will-conrad/plasma-donut/tools/README.md

# tools/

Helper scripts for working with the board, e.g. flashing a UF2 with `picotool`,
or opening the USB serial log (`screen /dev/tty.usbmodem* 115200`) and saving the
CSV output.
