will-conrad/plasma-donut/src/drivers/README.md

# drivers/

Chip-level drivers, one `.c`/`.h` pair per part (SDK `hardware_spi`, `hardware_adc`, `hardware_clocks`, `hardware_pio`):
- MCP3208 external ADC (SPI) — `../../docs/parts/mcp3208.md`
- ST7565R LCD controller / NHD-C12864LZ display (SPI) — `st7565r.md`, `nhd_c12864lz.md`
- RP2350 internal ADC (GPIO26–28) — `rp2350.md`, `pico2.md`
- Oscillator frequency counter on GPIO22 — `rp2350.md`
