will-conrad/plasma-donut/src/ui/README.md

# ui/

What the user sees and presses: LCD pages, button handling (debounce) —
`../../docs/parts/omron_b3f.md` — and backlight PWM (duty capped, see
`../../docs/ISSUES.md`).
