will-conrad/plasma-donut/docs/parts/specs.csv

part | category | parameter | symbol | min | typ | max | unit | conditions | pdf_page | section | tags
pico2 | power | VBUS input (USB) | VBUS |  | 5 |  | V | ±10% | 13 | Recommended operating conditions | usb,5v,supply
pico2 | power | VSYS input range | VSYS | 1.8 |  | 5.5 | V | feeds RT6150 buck-boost | 13 | Recommended operating conditions | vsys,supply,input
pico2 | power | 3V3 pin external load (recommended) |  |  |  | 300 | mA | depends on RP2350 load and VSYS | 10 | Pin descriptions (3V3) | 3v3,vcc,budget,current
pico2 | power | 3V3_EN pull-up |  |  | 100 |  | kΩ | to VSYS; short low to disable 3.3 V | 10 | Pin descriptions (3V3_EN) | enable
pico2 | power | VBUS→VSYS diode | D1 |  | Schottky |  |  | VSYS = VBUS − diode drop; safe to OR another source via diode/PFET | 16 | 5.4 Powerchain | oring,schottky,vsys
pico2 | analog | ADC_VREF filter | R7/C |  | 201 Ω / 2.2 µF |  |  | from 3V3; ~150 µA ADC draw gives ~30 mV offset | 15 | 5.3 Using the ADC | adc_vref,vref,offset
pico2 | analog | ADC_VREF external shunt option |  |  | 3.0 |  | V | LM4040 suggested; ~1.5 mA through 200 Ω | 15 | 5.3 Using the ADC | vref,lm4040
pico2 | io | ADC-capable GPIO26–29 max input |  |  |  | IOVDD+0.3 | V | internal diode to IOVDD; leaks into 3V3 if unpowered | 15 | 5.2 GPIO | gpio26,gpio27,gpio28,overvoltage
pico2 | io | Internal-use GPIOs |  |  |  |  |  | GPIO23 SMPS PS, GPIO24 VBUS sense, GPIO25 LED, GPIO29 VSYS/3 | 9 | Mechanical spec, pin notes | gpio23,gpio24,gpio25,gpio29,reserved
pico2 | pinout | Power pins |  |  |  |  |  | 40 VBUS, 39 VSYS, 37 3V3_EN, 36 3V3, 35 ADC_VREF, 33 AGND | 9 | Pin numbering | pinout,vbus,vsys
pico2 | thermal | Operating temperature |  | -20 |  | 85 | °C | incl. self-heating; recommended max ambient 70 °C | 13 | Recommended operating conditions | temperature
pico2 | power | SMPS mode pin | GPIO23 |  |  |  |  | drive high = PWM mode, lower ripple on ADC_VREF | 15 | 5.3 Using the ADC | ripple,noise,gpio23
rp2350 | absmax | IOVDD | IOVDD | -0.5 |  | 3.63 | V |  | 1336 | 14.9.1 Absolute maximum ratings | absmax,supply
rp2350 | absmax | Voltage at IO (standard pin) | VPIN | -0.5 |  | IOVDD+0.5 | V |  | 1336 | 14.9.1 | absmax,gpio,overvoltage
rp2350 | absmax | Voltage at IO (FT pin) | VPIN_FT | -0.5 |  | 5.5 | V | IOVDD = 3.3 V present; 3.63 V if IOVDD = 0 | 1336 | 14.9.1 | absmax,5v tolerant,ft
rp2350 | io | Input high (standard) | VIH | 2.0 |  | IOVDD+0.3 | V | IOVDD = 3.3 V | 1337 | 14.9.4 Table 1683 | vih,logic level
rp2350 | io | Input low | VIL | -0.3 |  | 0.8 | V | IOVDD = 3.3 V | 1337 | 14.9.4 | vil,logic level
rp2350 | io | Input hysteresis | VHYS | 0.2 |  |  | V | IOVDD = 3.3 V, Schmitt enabled | 1337 | 14.9.4 | schmitt,hysteresis
rp2350 | io | Output high | VOH | 2.62 |  | IOVDD | V | IOVDD = 3.3 V at IOH = 2/4/8/12 mA setting | 1337 | 14.9.4 | voh,drive
rp2350 | io | Output low | VOL | 0 |  | 0.5 | V | IOVDD = 3.3 V at IOL setting | 1337 | 14.9.4 | vol,drive
rp2350 | io | Pin input leakage | IIN |  |  | 1 | µA | (see erratum E9 for mid-rail inputs) | 1337 | 14.9.4 | leakage
rp2350 | io | Pull-up resistance | RPU | 32 |  | 86 | kΩ | IOVDD = 3.3 V | 1338 | 14.9.4 | pull-up,buttons
rp2350 | io | Pull-down resistance | RPD | 36 |  | 113 | kΩ | IOVDD = 3.3 V (unreliable: E9) | 1338 | 14.9.4 | pull-down,buttons,e9
rp2350 | io | Total GPIO source current | IIOVDD_MAX |  |  | 100 | mA | sum of all GPIO | 1338 | 14.9.4 | current,budget
rp2350 | io | Total GPIO sink current | IIOVSS_MAX |  |  | 100 | mA | sum of all GPIO | 1338 | 14.9.4 | current,budget
rp2350 | errata | E9: leakage when input pad is mid-rail | RP2350-E9 |  | 120 |  | µA | pad sources current, sits ~2.2 V; overcome with ≤8.2 kΩ drive; pull-ups OK, pull-downs fail | 1359 | Appendix D.5.1 | e9,errata,pull-down,leakage,buttons
rp2350 | pwm | PWM B pin as counter input | DIVMODE |  |  |  |  | only B pins (odd GPIO) count edges; high and low periods must each exceed one clk_sys period | 980 | 12.5 PWM (input modes) | frequency counter,pwm,odd gpio,edge count
rp2350 | pwm | Two GPIOs on the same PWM B input are OR'd |  |  |  |  |  | e.g. GPIO1 and GPIO17 are both PWM0 B — use a different slice for each frequency input | 976 | 12.5 GPIO→PWM mapping | pwm slice,conflict,frequency counter
rp2350 | clocks | Frequency counter FC0 interval vs accuracy | FC0_INTERVAL |  |  |  |  | 1 µs→2048 kHz … 500 µs→4 kHz; measures internal/GPIN clocks | 476 | 8.1.4 Frequency counter | frequency counter,gpin
rp2350 | thermal | Junction temperature | TJ | -40 |  | 125 | °C |  | 1336 | 14.9.1 | temperature
mcp3208 | absmax | VDD | VDD |  |  | 7.0 | V |  | 2 | 1.0 Absolute maximum | absmax,supply
mcp3208 | absmax | Any input/output |  | -0.6 |  | VDD+0.6 | V | w.r.t. VSS | 2 | 1.0 Absolute maximum | absmax,overvoltage,input
mcp3208 | power | Operating supply | VDD | 2.7 |  | 5.5 | V |  | 3 | Power requirements | supply
mcp3208 | power | Operating current | IDD |  | 320 | 400 | µA | VDD = VREF = 5 V; 225 µA typ at 2.7 V | 3 | Power requirements | current,budget
mcp3208 | accuracy | Resolution |  |  | 12 |  | bit |  | 2 | DC accuracy | resolution
mcp3208 | accuracy | INL | INL |  | ±0.75 | ±1 | LSB | -B grade; -C grade ±2 max | 2 | DC accuracy | inl,linearity,grade
mcp3208 | accuracy | DNL | DNL |  | ±0.5 | ±1 | LSB | no missing codes | 2 | DC accuracy | dnl
mcp3208 | accuracy | Offset error |  |  | ±1.25 | ±3 | LSB |  | 2 | DC accuracy | offset,calibration
mcp3208 | accuracy | Gain error |  |  | ±1.25 | ±5 | LSB |  | 2 | DC accuracy | gain,calibration
mcp3208 | reference | VREF range | VREF | 0.25 |  | VDD | V |  | 2 | Reference input | vref,vref_adc
mcp3208 | reference | VREF current |  |  | 100 | 150 | µA | while converting; 3 µA max in standby | 2 | Reference input | vref,load
mcp3208 | analog | Analog input range CH0–7 |  | VSS |  | VREF | V | single-ended | 2 | Analog inputs | input range
mcp3208 | analog | Sample capacitor | CSAMPLE |  | 20 |  | pF |  | 3 | Analog inputs / Fig 4-1 | source impedance,sample cap,kickback
mcp3208 | analog | Sampling switch resistance | RSS |  | 1000 |  | Ω |  | 3 | Analog inputs / Fig 4-1 | source impedance
mcp3208 | timing | Sample time | tSAMPLE |  | 1.5 |  | clocks |  | 2 | Conversion rate | source impedance,acquisition
mcp3208 | timing | Conversion time | tCONV |  |  | 12 | clocks |  | 2 | Conversion rate
mcp3208 | timing | Throughput | fSAMPLE |  |  | 100 / 50 | ksps | VDD = 5 V / 2.7 V | 2 | Conversion rate | sample rate
mcp3208 | timing | SPI clock | fCLK |  |  | 2.0 / 1.0 | MHz | VDD = 5 V / 2.7 V | 3 | Timing parameters | spi,clock,speed
mcp3208 | timing | Minimum effective clock |  | 10 |  |  | kHz | below this the sample cap droops (Note 3, §6.2) | 3 | Timing note 3 | spi,clock,minimum
mcp3208 | timing | CS disable time | tCSH | 500 |  |  | ns |  | 3 | Timing parameters | spi,cs
mcp3208 | digital | VIH / VIL |  | 0.7·VDD |  | 0.3·VDD | V |  | 3 | Digital I/O | logic level
mcp3208 | interface | SPI modes |  |  | 0,0 and 1,1 |  |  | 3-byte transfer, §6.1 | 1 | Features / §6.1 | spi,mode
mcp3208 | pinout | SOIC-16 pinout |  |  |  |  |  | 1–8 CH0–CH7, 9 DGND, 10 CS/SHDN, 11 DIN, 12 DOUT, 13 CLK, 14 AGND, 15 VREF, 16 VDD | 15 | Table 3-1 | pinout
mcp3208 | layout | Bypass capacitor |  |  | 1 |  | µF | as close as possible to VDD pin | 23 | 6.4 Layout considerations | decoupling,bypass,layout
mcp3208 | layout | Ground pins |  |  |  |  |  | connect BOTH AGND and DGND to the analog ground plane (internally 5–10 Ω apart) | 24 | 6.5 Digital and analog ground pins | gnda,ground,layout
mcp3208 | layout | Trace routing |  |  |  |  |  | keep digital/clock traces away from analog; no traces under device or bypass cap; star VDD | 23 | 6.4 Layout considerations | layout,routing
mcp3208 | thermal | Operating temperature | TA | -40 |  | 125 | °C |  | 4 | Temperature characteristics | temperature
nhd_c12864lz | power | Supply voltage | VDD | 2.7 | 3.0 | 3.3 | V |  | 7 | Electrical characteristics | supply,vcc,3v3
nhd_c12864lz | power | Supply current | IDD | 0.2 | 0.5 | 2.0 | mA | VDD = 3.0 V | 7 | Electrical characteristics | current,budget
nhd_c12864lz | power | LCD drive (contrast) voltage | VLCD | 8.2 | 8.5 | 8.8 | V | 25 °C, generated internally | 7 | Electrical characteristics | contrast,vlcd
nhd_c12864lz | digital | Input high | VIH | 0.8·VDD |  | VDD | V | = 2.64 V at 3.3 V | 7 | Electrical characteristics | logic level,vih
nhd_c12864lz | digital | Input low | VIL | VSS |  | 0.2·VDD | V |  | 7 | Electrical characteristics | logic level,vil
nhd_c12864lz | backlight | LED backlight current | ILED | 60 | 80 | 100 | mA | drive by current, not voltage | 7 | Electrical characteristics | backlight,led,current
nhd_c12864lz | backlight | LED backlight voltage | VLED | 2.7 | 3.0 | 3.3 | V | ILED = 80 mA | 7 | Electrical characteristics | backlight,led,forward voltage
nhd_c12864lz | thermal | Operating temperature | TOP | -20 |  | 70 | °C |  | 7 | Electrical characteristics | temperature,heat
nhd_c12864lz | pinout | 28-pin LCD connector |  |  |  |  |  | 1 /CS1, 2 /RES, 3 A0, 4 /WR, 5 /RD, 6–11 DB0–DB5 (NC in serial), 12 DB6=SCL, 13 DB7=SI, 14 VDD, 15 VSS, 16 VOUT, 17–21 charge-pump caps, 22–26 V4–V0, 27 C86, 28 PS (L = serial) | 6 | Pin description | pinout,spi,serial
nhd_c12864lz | passives | Charge-pump and bias caps |  |  | 1 |  | µF | VOUT, CAP pins 1 µF; V0–V4 1.0–2.2 µF to VSS | 6 | Pin description | capacitors,bom
nhd_c12864lz | mechanical | Connector pitch |  |  | 1.27 |  | mm | LCD pins; backlight pins 1.5 mm wide; breakout NHD-PCB40 | 6 | Pin description | footprint,pitch
nhd_c12864lz | firmware | Example init sequence |  |  |  |  |  | A2, A0, C8, C0, 40, 25, 81, 19, 2F, AF (note C8 is immediately overridden by C0) | 13 | Example initialization program | init,firmware,contrast
nhd_c12864lz | optical | Response time (rise) | Tr |  | 150 |  | ms |  | 7 | Optical characteristics
st7565r | absmax | Supply VDD / VDD2 | VDD | -0.3 |  | 3.6 | V |  | 56 | Absolute maximum ratings | absmax,supply
st7565r | absmax | V0, VOUT |  | -0.3 |  | 13.5 | V |  | 56 | Absolute maximum ratings | absmax
st7565r | timing | 4-line SPI clock period | tSCYC | 50 |  |  | ns | VDD = 3.3 V (100 ns at 2.7 V) | 64 | Table 28/29 | spi,clock,speed
st7565r | timing | SCL high / low width | tSHW/tSLW | 25 |  |  | ns | VDD = 3.3 V (50 ns at 2.7 V) | 64 | Table 28/29 | spi
st7565r | timing | A0 setup / hold | tSAS/tSAH | 20 / 10 |  |  | ns | VDD = 3.3 V (30/20 ns at 2.7 V) | 64 | Table 28/29 | spi,a0
st7565r | timing | SI setup / hold | tSDS/tSDH | 20 / 10 |  |  | ns | VDD = 3.3 V | 64 | Table 28/29 | spi
st7565r | timing | CS–SCL time | tCSS/tCSH | 20 / 40 |  |  | ns | VDD = 3.3 V (30/60 ns at 2.7 V) | 64 | Table 28/29 | spi,cs
st7565r | timing | Reset low pulse width | tRW | 1.0 |  |  | µs | VDD = 3.3 V (2.0 µs at 2.7 V) | 65 | Table 30/31 | reset
st7565r | timing | Reset time | tR |  |  | 1.0 | µs | VDD = 3.3 V (2.0 µs at 2.7 V) | 65 | Table 30/31 | reset
st7565r | interface | SPI data format |  |  |  |  |  | SI sampled on SCL rising edge, MSB (D7) first; A0 read every 8th clock; write-only (no reads in SPI mode) | 24 | 4-line SPI interface | spi,mode,msb
st7565r | interface | SCL noise caution |  |  |  |  |  | SCL sensitive to line-end reflections and external noise — recheck on real hardware | 24 | 4-line SPI interface | noise,rf,emi
ntcs0603e3 | electrical | R25 | R25 |  | 10000 |  | Ω | 103 = 10 kΩ | 1 | Electrical data and ordering | resistance
ntcs0603e3 | electrical | R25 tolerance (F suffix) |  |  | ±1 |  | % | J ±5, H ±3, G ±2, F ±1 | 1 | Ordering note 1 | tolerance
ntcs0603e3 | electrical | B25/85 (…103*LT) | B25/85 |  | 3435 |  | K | ±1 %; 'L' = 3435 K, 'M' = 3610 K, 'H' = 3960 K | 1 | Electrical data and ordering | beta,b value,firmware
ntcs0603e3 | electrical | Max power at 25 °C | Pmax25 |  |  | 125 | mW |  | 1 | Quick reference data | power,self-heating
ntcs0603e3 | electrical | Dissipation factor | D |  | 3.0 |  | mW/K |  | 1 | Quick reference data | self-heating
ntcs0603e3 | thermal | Thermal time constant | τ |  |  | <4 | s |  | 1 | Quick reference data | response time
ntcs0603e3 | thermal | Operating temperature |  | -55 |  | 150 | °C | zero power | 1 | Quick reference data | temperature
ao3400a | absmax | Drain-source voltage | VDS |  |  | 30 | V |  | 1 | Absolute maximum | absmax
ao3400a | absmax | Gate-source voltage | VGS | -12 |  | 12 | V |  | 1 | Absolute maximum | absmax,gate
ao3400a | absmax | Continuous drain current | ID |  |  | 5.7 | A | TA = 25 °C (4.7 A at 70 °C) | 1 | Absolute maximum | current
ao3400a | electrical | Gate threshold | VGS(th) | 0.65 | 1.05 | 1.45 | V | ID = 250 µA | 2 | Static parameters | threshold,logic level
ao3400a | electrical | RDS(on) at VGS = 2.5 V | RDS(on) |  | 24 | 48 | mΩ | ID = 3 A | 2 | Static parameters | rdson,3.3v gate
ao3400a | electrical | RDS(on) at VGS = 4.5 V | RDS(on) |  | 19 | 32 | mΩ | ID = 5 A | 2 | Static parameters | rdson
ao3400a | electrical | Input capacitance | Ciss |  | 630 |  | pF | VDS = 15 V, 1 MHz | 2 | Dynamic parameters | gate charge,pwm
ao3400a | electrical | Total gate charge | Qg |  | 6 | 7 | nC | VGS = 4.5 V | 2 | Switching parameters | gate charge,pwm
ao3400a | thermal | RθJA steady state | RθJA |  | 100 | 125 | °C/W | 1 in² 2 oz Cu | 1 | Thermal characteristics | thermal
ao3400a | pinout | SOT-23 pinout |  |  |  |  |  | 1 G, 2 S, 3 D | 1 | Package drawing | pinout
nx_74lvc1g17 | pinout | SOT753 (GV) pinout |  |  |  |  |  | 1 n.c., 2 A, 3 GND, 4 Y, 5 VCC — matches U4/U5 pads | 3 | 6.2 Table 3 | pinout
nx_74lvc1g17 | absmax | VCC / VI |  | -0.5 |  | 6.5 | V | VI negative rating may be exceeded if IIK ≤ 50 mA | 4 | 8 Table 5 | absmax,negative input,clamp
nx_74lvc1g17 | absmax | Input clamp current | IIK | -50 |  |  | mA | VI < 0 V | 4 | 8 Table 5 | clamp
nx_74lvc1g17 | power | VI (operating) | VI | 0 |  | 5.5 | V |  | 5 | 9 Table 6 | input range
nx_74lvc1g17 | threshold | Positive-going threshold | VT+ | 1.29 | 1.5 | 1.71 | V | VCC = 3.0 V, −40…85 °C (no 3.3 V row) | 6 | 10.1 Table 8 | schmitt,threshold,bias
nx_74lvc1g17 | threshold | Negative-going threshold | VT− | 0.88 | 1.0 | 1.24 | V | VCC = 3.0 V | 6 | 10.1 Table 8 | schmitt,threshold,bias
nx_74lvc1g17 | threshold | Hysteresis | VH | 0.31 | 0.5 | 0.64 | V | VCC = 3.0 V | 6 | 10.1 Table 8 | hysteresis
nx_74lvc1g17 | timing | Propagation delay A→Y | tpd | 0.7 | 3.0 | 5.5 | ns | VCC 3.0–3.6 V, CL = 50 pF, RL = 500 Ω | 8 | 11 Table 9 | tpd,skew,phase
nx_74lvc1g17 | power | Power dissipation capacitance | CPD |  | 16.6 |  | pF | VCC = 3.3 V | 8 | Table 9 note 3 | dynamic current
nx_74lvc1g17 | power | Supply current | ICC |  | 0.1 | 4 | µA | VI = rail, IO = 0 | 5 | 10 Table 7 | current
nx_74lvc1g17 | power | Extra current, input at VCC−0.6 V | ΔICC |  | 5 | 500 | µA | per input | 6 | 10 Table 7 | bias,current
nx_74lvc1g86 | pinout | SOT753 (GV) pinout |  |  |  |  |  | 1 B, 2 A, 3 GND, 4 Y, 5 VCC — matches U3 pads | 3 | 6.2 Table 3 | pinout
nx_74lvc1g86 | absmax | VCC / VI |  | -0.5 |  | 6.5 | V |  | 4 | 8 Table 5 | absmax
nx_74lvc1g86 | digital | VIH / VIL |  | 2.0 |  | 0.8 | V | VCC 2.7–3.6 V (min VIH / max VIL) | 5 | 10 Table 7 | logic level
nx_74lvc1g86 | digital | VOH at −100 µA | VOH | VCC−0.1 |  |  | V | light load (R20 10k into C26) | 5 | 10 Table 7 | phase,output level
nx_74lvc1g86 | digital | VOL at 100 µA | VOL |  |  | 0.10 | V |  | 5 | 10 Table 7 | phase,output level
nx_74lvc1g86 | timing | Propagation delay A/B→Y | tpd | 0.5 | 2.3 | 5.0 | ns | VCC 3.0–3.6 V, CL = 50 pF | 6 | 11 Table 8 | tpd,phase
nx_74lvc1g86 | power | Power dissipation capacitance | CPD |  | 25 |  | pF | VCC = 3.3 V | 6 | Table 8 | dynamic current
yageo_rc_l | power | RC0805 rated power | P70 |  |  | 0.125 | W | at 70 °C, derate to 0 at 155 °C | 5 | Electrical characteristics / Power rating | power,derating,0805
yageo_rc_l | power | RC1206 rated power | P70 |  |  | 0.25 | W | at 70 °C (R1 24 Ω) | 6 | Electrical characteristics | power,1206,backlight
yageo_rc_l | electrical | RC0805 max working voltage |  |  |  | 150 | V | overload 300 V | 5 | Electrical characteristics | voltage,0805
yageo_rc_l | electrical | RC1206 max working voltage |  |  |  | 200 | V | overload 400 V | 6 | Electrical characteristics | voltage,1206
yageo_rc_l | electrical | TCR (1 %, 10 Ω–10 MΩ) |  |  |  | ±100 | ppm/°C |  | 5 | Electrical characteristics | tcr
omron_b3f | electrical | Switch rating (resistive) |  | 1 |  | 50 | mA | 3–24 VDC (B3F-G variant for 100 µA) | 3 | Ratings/Characteristics | switch,minimum current,buttons
omron_b3f | electrical | Bounce time |  |  |  | 5 | ms |  | 3 | Ratings/Characteristics | debounce,buttons
omron_b3f | electrical | Contact resistance |  |  |  | 100 | mΩ | initial | 3 | Ratings/Characteristics | contact
omron_b3f | thermal | Operating temperature |  | -25 |  | 70 | °C |  | 3 | Ratings/Characteristics | temperature
rp2350 | adc | ADC input range | VPIN_ADC | 0 |  | ADC_AVDD | V |  | 1339 | 14.9 Table 1685 | adc,vdd tap,passive
rp2350 | adc | ADC ENOB | ENOB | 9 | 9.5 |  | bits |  | 1339 | Table 1685 | adc,resolution
rp2350 | adc | ADC input impedance | RIN_ADC | 100 |  |  | kΩ | loads high-Z dividers (DC-07) | 1339 | Table 1685 | adc,impedance,divider
rp2350 | clocks | GPIN0/GPIN1 clock inputs |  |  |  | 50 | MHz | GPIN0 = GPIO20, GPIN1 = GPIO22 (FREQ_QUARTZ!) → measurable with FC0 | 19 | Pin function table / 8.1 | gpin,gpio22,frequency counter
rp2350 | clocks | FC0 longest interval | FC0_INTERVAL |  |  | 32 ms → 62.5 Hz |  | accuracy vs interval | 476 | Table 574 | frequency counter,resolution
