will-conrad/plasma-donut/docs/rework_map.png

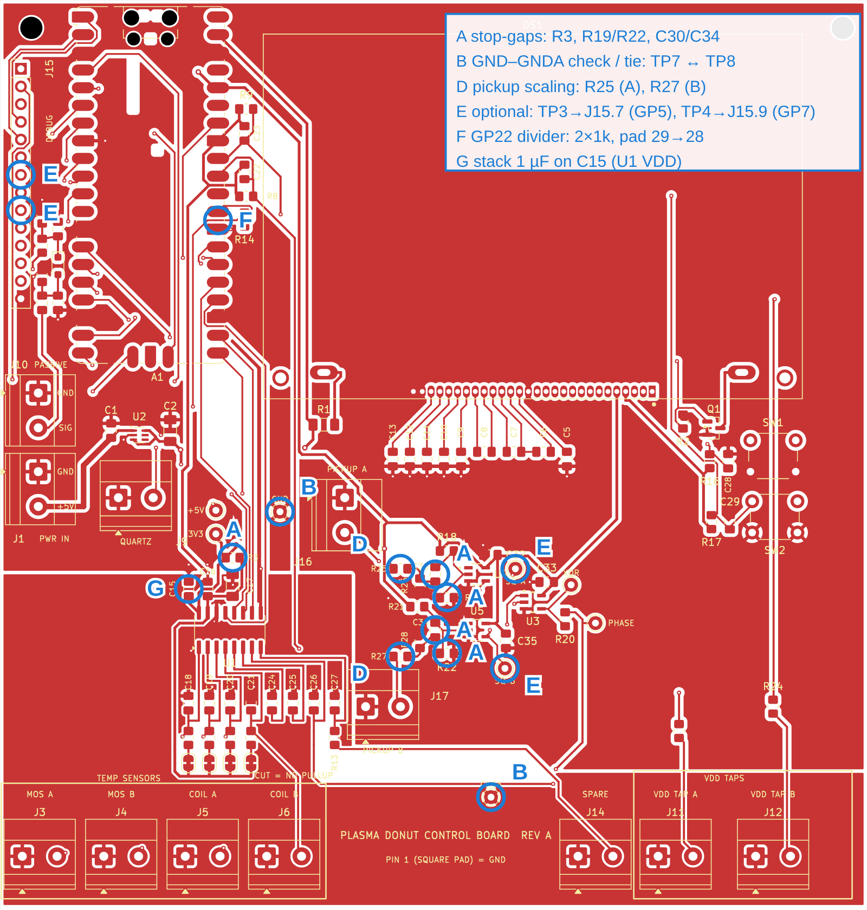
docs/rework_map.png
