will-conrad/plasma-donut/docs/parts/ao3400a.md

# AO3400A

| | |
|---|---|
| Manufacturer | Alpha & Omega |
| Role on board | Low-side N-FET for LCD backlight (PWM) |
| Ref des | Q1 |
| Datasheet | [pdf/ao3400a.pdf](../pdf/ao3400a.pdf) · text [text/ao3400a.txt](../text/ao3400a.txt) · 5 pages |
| Revision | Rev 3.1 (Jul 2023) |
| Source | https://www.aosmd.com/res/datasheets/AO3400A.pdf |
| Requirements / checks | REQ-13; DC-14 (see [design-requirements.md](../design-requirements.md), [ISSUES.md](../ISSUES.md)) |

## How it's used on this board

- Q1: gate GP14 (PWM7 A) with R2 100k pull-down; drain = LCD LED cathode; LED anode via R1 24 Ω to +5V.

## Gotchas and design notes

- VGS(th) max is 1.45 V, and R_DS(on) is 48 mΩ max at V_GS = 2.5 V (p.2), so a 3.3 V gate turns it fully on (DC-14).
- Gate absolute max is ±12 V (p.1).
- Qg is about 6 nC (p.2). At 1 kHz PWM the switching loss is trivial, and no gate driver is needed.
- Pinout is 1 = G, 2 = S, 3 = D. Check the footprint against this.

## Key specs (from the datasheet)

| Category | Parameter | Sym | Min | Typ | Max | Unit | Conditions | Page |
|---|---|---|---|---|---|---|---|---|
| absmax | Drain-source voltage | VDS |  |  | 30 | V |  | [p.1](../pdf/ao3400a.pdf#page=1) |
| absmax | Gate-source voltage | VGS | -12 |  | 12 | V |  | [p.1](../pdf/ao3400a.pdf#page=1) |
| absmax | Continuous drain current | ID |  |  | 5.7 | A | TA = 25 °C (4.7 A at 70 °C) | [p.1](../pdf/ao3400a.pdf#page=1) |
| electrical | Gate threshold | VGS(th) | 0.65 | 1.05 | 1.45 | V | ID = 250 µA | [p.2](../pdf/ao3400a.pdf#page=2) |
| electrical | RDS(on) at VGS = 2.5 V | RDS(on) |  | 24 | 48 | mΩ | ID = 3 A | [p.2](../pdf/ao3400a.pdf#page=2) |
| electrical | RDS(on) at VGS = 4.5 V | RDS(on) |  | 19 | 32 | mΩ | ID = 5 A | [p.2](../pdf/ao3400a.pdf#page=2) |
| electrical | Input capacitance | Ciss |  | 630 |  | pF | VDS = 15 V, 1 MHz | [p.2](../pdf/ao3400a.pdf#page=2) |
| electrical | Total gate charge | Qg |  | 6 | 7 | nC | VGS = 4.5 V | [p.2](../pdf/ao3400a.pdf#page=2) |
| thermal | RθJA steady state | RθJA |  | 100 | 125 | °C/W | 1 in² 2 oz Cu | [p.1](../pdf/ao3400a.pdf#page=1) |
| pinout | SOT-23 pinout |  |  |  |  |  | 1 G, 2 S, 3 D | [p.1](../pdf/ao3400a.pdf#page=1) |

_Pages are PDF page numbers (they match the `=== p.N ===` markers in the text file)._
