will-conrad/plasma-donut/docs/parts/mcp3208.md

# MCP3208 (MCP3204/3208)

| | |
|---|---|
| Manufacturer | Microchip |
| Role on board | 8-ch 12-bit SPI ADC; ref = /VREF_ADC |
| Ref des | U1 (MCP3208-CI/SL, C grade) |
| Datasheet | [pdf/mcp3208.pdf](../pdf/mcp3208.pdf) · text [text/mcp3208.txt](../text/mcp3208.txt) · 40 pages |
| Revision | DS21298E (2008) |
| Source | https://ww1.microchip.com/downloads/en/DeviceDoc/21298e.pdf |
| Requirements / checks | REQ-01, REQ-02, REQ-04, REQ-07, REQ-14; DC-04, DC-05, DC-06, DC-07, DC-16 (see [design-requirements.md](../design-requirements.md), [ISSUES.md](../ISSUES.md)) |

## How it's used on this board

- U1 channels (from netlist): CH0–3 thermistors (MOS A, MOS B, Coil A, Coil B), **CH4/CH5 /PICKUP_A/B = only a 0.1 µF cap, nothing drives them**, CH6 /PHASE, CH7 /ANALOG_SPARE (J14 via R13 1k).
- VDD = VCC; VREF = /VREF_ADC = VCC through R3 10 Ω with C16 0.1 µF + C17 10 µF. AGND → GNDA, **DGND → GND**.
- SPI0: SCK GP18, MOSI GP19, MISO GP16, CS GP17 (own bus; LCD is on SPI1).

## Gotchas and design notes

- The max clock is only given at 2.7 V (1 MHz) and 5 V (2 MHz), so stay at about 1 MHz at 3.3 V. Don't go below 10 kHz either, or the sample cap droops (p.3, note 3).
- During sampling the input sees 20 pF behind 1 kΩ for 1.5 clocks (p.3, p.17). High-impedance sources need a cap at the pin or a slower clock (see DC-05).
- Connect both AGND and DGND to the **analog** ground plane (p.24). Put a 1 µF bypass right at VDD, and keep clock/digital traces out from under the chip (p.23).
- VREF has to be between 0.25 V and VDD, and it draws 100–150 µA while converting (p.2). That load matters if VREF comes through a resistor (DC-06).
- An input above VDD + 0.6 V exceeds absolute max (p.2). The datasheet gives no injection-current rating (see DC-07).
- Grade: -B is INL ±1 LSB, -C is ±2 LSB (p.2). Check which suffix was ordered.

## Key specs (from the datasheet)

| Category | Parameter | Sym | Min | Typ | Max | Unit | Conditions | Page |
|---|---|---|---|---|---|---|---|---|
| absmax | VDD | VDD |  |  | 7.0 | V |  | [p.2](../pdf/mcp3208.pdf#page=2) |
| absmax | Any input/output |  | -0.6 |  | VDD+0.6 | V | w.r.t. VSS | [p.2](../pdf/mcp3208.pdf#page=2) |
| power | Operating supply | VDD | 2.7 |  | 5.5 | V |  | [p.3](../pdf/mcp3208.pdf#page=3) |
| power | Operating current | IDD |  | 320 | 400 | µA | VDD = VREF = 5 V; 225 µA typ at 2.7 V | [p.3](../pdf/mcp3208.pdf#page=3) |
| accuracy | Resolution |  |  | 12 |  | bit |  | [p.2](../pdf/mcp3208.pdf#page=2) |
| accuracy | INL | INL |  | ±0.75 | ±1 | LSB | -B grade; -C grade ±2 max | [p.2](../pdf/mcp3208.pdf#page=2) |
| accuracy | DNL | DNL |  | ±0.5 | ±1 | LSB | no missing codes | [p.2](../pdf/mcp3208.pdf#page=2) |
| accuracy | Offset error |  |  | ±1.25 | ±3 | LSB |  | [p.2](../pdf/mcp3208.pdf#page=2) |
| accuracy | Gain error |  |  | ±1.25 | ±5 | LSB |  | [p.2](../pdf/mcp3208.pdf#page=2) |
| reference | VREF range | VREF | 0.25 |  | VDD | V |  | [p.2](../pdf/mcp3208.pdf#page=2) |
| reference | VREF current |  |  | 100 | 150 | µA | while converting; 3 µA max in standby | [p.2](../pdf/mcp3208.pdf#page=2) |
| analog | Analog input range CH0–7 |  | VSS |  | VREF | V | single-ended | [p.2](../pdf/mcp3208.pdf#page=2) |
| analog | Sample capacitor | CSAMPLE |  | 20 |  | pF |  | [p.3](../pdf/mcp3208.pdf#page=3) |
| analog | Sampling switch resistance | RSS |  | 1000 |  | Ω |  | [p.3](../pdf/mcp3208.pdf#page=3) |
| timing | Sample time | tSAMPLE |  | 1.5 |  | clocks |  | [p.2](../pdf/mcp3208.pdf#page=2) |
| timing | Conversion time | tCONV |  |  | 12 | clocks |  | [p.2](../pdf/mcp3208.pdf#page=2) |
| timing | Throughput | fSAMPLE |  |  | 100 / 50 | ksps | VDD = 5 V / 2.7 V | [p.2](../pdf/mcp3208.pdf#page=2) |
| timing | SPI clock | fCLK |  |  | 2.0 / 1.0 | MHz | VDD = 5 V / 2.7 V | [p.3](../pdf/mcp3208.pdf#page=3) |
| timing | Minimum effective clock |  | 10 |  |  | kHz | below this the sample cap droops (Note 3, §6.2) | [p.3](../pdf/mcp3208.pdf#page=3) |
| timing | CS disable time | tCSH | 500 |  |  | ns |  | [p.3](../pdf/mcp3208.pdf#page=3) |
| digital | VIH / VIL |  | 0.7·VDD |  | 0.3·VDD | V |  | [p.3](../pdf/mcp3208.pdf#page=3) |
| interface | SPI modes |  |  | 0,0 and 1,1 |  |  | 3-byte transfer, §6.1 | [p.1](../pdf/mcp3208.pdf#page=1) |
| pinout | SOIC-16 pinout |  |  |  |  |  | 1–8 CH0–CH7, 9 DGND, 10 CS/SHDN, 11 DIN, 12 DOUT, 13 CLK, 14 AGND, 15 VREF, 16 VDD | [p.15](../pdf/mcp3208.pdf#page=15) |
| layout | Bypass capacitor |  |  | 1 |  | µF | as close as possible to VDD pin | [p.23](../pdf/mcp3208.pdf#page=23) |
| layout | Ground pins |  |  |  |  |  | connect BOTH AGND and DGND to the analog ground plane (internally 5–10 Ω apart) | [p.24](../pdf/mcp3208.pdf#page=24) |
| layout | Trace routing |  |  |  |  |  | keep digital/clock traces away from analog; no traces under device or bypass cap; star VDD | [p.23](../pdf/mcp3208.pdf#page=23) |
| thermal | Operating temperature | TA | -40 |  | 125 | °C |  | [p.4](../pdf/mcp3208.pdf#page=4) |

_Pages are PDF page numbers (they match the `=== p.N ===` markers in the text file)._
