will-conrad/plasma-donut/docs/parts/ntcs0603e3.md

# NTCS0603E3103FLT

| | |
|---|---|
| Manufacturer | Vishay BCcomponents |
| Role on board | 10 kΩ NTC thermistors x4 (MOS A, MOS B, Coil A, Coil B) |
| Ref des | off-board ×4, on J3–J6 |
| Datasheet | [pdf/ntcs0603e3.pdf](../pdf/ntcs0603e3.pdf) · text [text/ntcs0603e3.txt](../text/ntcs0603e3.txt) · 3 pages |
| Revision | Doc 29056, rev 29-Sep-2026 |
| Source | https://www.vishay.com/docs/29056/ntcs0603e3t.pdf |
| Requirements / checks | REQ-01, REQ-02, REQ-03; DC-08 (see [design-requirements.md](../design-requirements.md), [ISSUES.md](../ISSUES.md)) |

## How it's used on this board

- Off-board, wired to J3–J6. Divider: R4–R7 10k from /VREF_ADC (through solder jumpers JP1–JP4 'PU CUT') on top, NTC to GNDA on the bottom, C18–C21 0.1 µF at the ADC pin.
- Ratiometric: $R = 10\,\text{k}\Omega \cdot N/(4096-N)$, so /VREF_ADC drift cancels.

## Gotchas and design notes

- This datasheet confirms B: the 'L' code in NTCS0603E3103**F**L**T** means B25/85 = **3435 K ±1 %**, and **F** means R25 ±1 % (p.1).
- B25/85 is fitted at 25 °C and 85 °C. Above 85 °C, the Beta model drifts from the real curve, so use Vishay's R-T table (a separate document, not included here) if you need accuracy at MOSFET temperatures.
- Dissipation factor is 3.0 mW/K, so self-heating is negligible in a 10 k divider at 3.3 V (DC-08).
- Thermal time constant is under 4 s (p.1). The reading lags the real temperature by seconds, which matters for over-temperature warnings.
- Rated to 150 °C. For this measurement, the limit is the solder and mounting rather than the part.

## Key specs (from the datasheet)

| Category | Parameter | Sym | Min | Typ | Max | Unit | Conditions | Page |
|---|---|---|---|---|---|---|---|---|
| electrical | R25 | R25 |  | 10000 |  | Ω | 103 = 10 kΩ | [p.1](../pdf/ntcs0603e3.pdf#page=1) |
| electrical | R25 tolerance (F suffix) |  |  | ±1 |  | % | J ±5, H ±3, G ±2, F ±1 | [p.1](../pdf/ntcs0603e3.pdf#page=1) |
| electrical | B25/85 (…103*LT) | B25/85 |  | 3435 |  | K | ±1 %; 'L' = 3435 K, 'M' = 3610 K, 'H' = 3960 K | [p.1](../pdf/ntcs0603e3.pdf#page=1) |
| electrical | Max power at 25 °C | Pmax25 |  |  | 125 | mW |  | [p.1](../pdf/ntcs0603e3.pdf#page=1) |
| electrical | Dissipation factor | D |  | 3.0 |  | mW/K |  | [p.1](../pdf/ntcs0603e3.pdf#page=1) |
| thermal | Thermal time constant | τ |  |  | <4 | s |  | [p.1](../pdf/ntcs0603e3.pdf#page=1) |
| thermal | Operating temperature |  | -55 |  | 150 | °C | zero power | [p.1](../pdf/ntcs0603e3.pdf#page=1) |

_Pages are PDF page numbers (they match the `=== p.N ===` markers in the text file)._
