will-conrad/plasma-donut/docs/parts/rp2350.md

# RP2350 (A2 stepping on Pico 2)

| | |
|---|---|
| Manufacturer | Raspberry Pi |
| Role on board | Microcontroller silicon on the Pico 2 (GPIO, PWM, SPI, errata) |
| Ref des | (inside A1) |
| Datasheet | [pdf/rp2350.pdf](../pdf/rp2350.pdf) · text [text/rp2350.txt](../text/rp2350.txt) · 1371 pages |
| Revision | Build date 01/10/2026 |
| Source | https://datasheets.raspberrypi.com/rp2350/rp2350-datasheet.pdf |
| Requirements / checks | REQ-06, REQ-08, REQ-12; DC-03, DC-11, DC-12 (see [design-requirements.md](../design-requirements.md), [ISSUES.md](../ISSUES.md)) |

## How it's used on this board

- The silicon inside the Pico 2. This datasheet has the GPIO electrical limits, the PWM edge-counter used to measure frequency, the SPI peripheral and the errata.

## Gotchas and design notes

- **Erratum E9 (p.1359):** an input pad that sits between VIL and VIH leaks about 120 µA and floats to about 2.2 V. Internal pull-downs can't overcome it, but internal pull-ups work. Pulling the pin down needs 8.2 kΩ or less. So: buttons are active-low with pull-ups, and any slow or analog-ish signal on a GPIO needs a low-impedance driver.
- **Frequency counting (p.980):** only PWM **B** pins (odd GPIOs) can count edges. Both the high and low halves of the input must be longer than one clk_sys period. 13.56 MHz has a 36.9 ns half-period, against 6.7 ns for clk_sys at 150 MHz, so it's fine.
- **PWM slice sharing (p.976):** GPIO *n* and GPIO *n*+16 drive the same PWM channel. If two frequency inputs share a slice's B input, the counter sees the OR of the two signals. Put each frequency input on its own slice.
- Logic levels at 3.3 V (p.1337): VIH ≥ 2.0 V, VIL ≤ 0.8 V, VOH ≥ 2.62 V at the rated drive current.
- All GPIOs together can source at most 100 mA and sink at most 100 mA (p.1338).
- The PDF has 1371 pages, so search text/rp2350.txt rather than reading it.

## Key specs (from the datasheet)

| Category | Parameter | Sym | Min | Typ | Max | Unit | Conditions | Page |
|---|---|---|---|---|---|---|---|---|
| absmax | IOVDD | IOVDD | -0.5 |  | 3.63 | V |  | [p.1336](../pdf/rp2350.pdf#page=1336) |
| absmax | Voltage at IO (standard pin) | VPIN | -0.5 |  | IOVDD+0.5 | V |  | [p.1336](../pdf/rp2350.pdf#page=1336) |
| absmax | Voltage at IO (FT pin) | VPIN_FT | -0.5 |  | 5.5 | V | IOVDD = 3.3 V present; 3.63 V if IOVDD = 0 | [p.1336](../pdf/rp2350.pdf#page=1336) |
| io | Input high (standard) | VIH | 2.0 |  | IOVDD+0.3 | V | IOVDD = 3.3 V | [p.1337](../pdf/rp2350.pdf#page=1337) |
| io | Input low | VIL | -0.3 |  | 0.8 | V | IOVDD = 3.3 V | [p.1337](../pdf/rp2350.pdf#page=1337) |
| io | Input hysteresis | VHYS | 0.2 |  |  | V | IOVDD = 3.3 V, Schmitt enabled | [p.1337](../pdf/rp2350.pdf#page=1337) |
| io | Output high | VOH | 2.62 |  | IOVDD | V | IOVDD = 3.3 V at IOH = 2/4/8/12 mA setting | [p.1337](../pdf/rp2350.pdf#page=1337) |
| io | Output low | VOL | 0 |  | 0.5 | V | IOVDD = 3.3 V at IOL setting | [p.1337](../pdf/rp2350.pdf#page=1337) |
| io | Pin input leakage | IIN |  |  | 1 | µA | (see erratum E9 for mid-rail inputs) | [p.1337](../pdf/rp2350.pdf#page=1337) |
| io | Pull-up resistance | RPU | 32 |  | 86 | kΩ | IOVDD = 3.3 V | [p.1338](../pdf/rp2350.pdf#page=1338) |
| io | Pull-down resistance | RPD | 36 |  | 113 | kΩ | IOVDD = 3.3 V (unreliable: E9) | [p.1338](../pdf/rp2350.pdf#page=1338) |
| io | Total GPIO source current | IIOVDD_MAX |  |  | 100 | mA | sum of all GPIO | [p.1338](../pdf/rp2350.pdf#page=1338) |
| io | Total GPIO sink current | IIOVSS_MAX |  |  | 100 | mA | sum of all GPIO | [p.1338](../pdf/rp2350.pdf#page=1338) |
| errata | E9: leakage when input pad is mid-rail | RP2350-E9 |  | 120 |  | µA | pad sources current, sits ~2.2 V; overcome with ≤8.2 kΩ drive; pull-ups OK, pull-downs fail | [p.1359](../pdf/rp2350.pdf#page=1359) |
| pwm | PWM B pin as counter input | DIVMODE |  |  |  |  | only B pins (odd GPIO) count edges; high and low periods must each exceed one clk_sys period | [p.980](../pdf/rp2350.pdf#page=980) |
| pwm | Two GPIOs on the same PWM B input are OR'd |  |  |  |  |  | e.g. GPIO1 and GPIO17 are both PWM0 B — use a different slice for each frequency input | [p.976](../pdf/rp2350.pdf#page=976) |
| clocks | Frequency counter FC0 interval vs accuracy | FC0_INTERVAL |  |  |  |  | 1 µs→2048 kHz … 500 µs→4 kHz; measures internal/GPIN clocks | [p.476](../pdf/rp2350.pdf#page=476) |
| thermal | Junction temperature | TJ | -40 |  | 125 | °C |  | [p.1336](../pdf/rp2350.pdf#page=1336) |
| adc | ADC input range | VPIN_ADC | 0 |  | ADC_AVDD | V |  | [p.1339](../pdf/rp2350.pdf#page=1339) |
| adc | ADC ENOB | ENOB | 9 | 9.5 |  | bits |  | [p.1339](../pdf/rp2350.pdf#page=1339) |
| adc | ADC input impedance | RIN_ADC | 100 |  |  | kΩ | loads high-Z dividers (DC-07) | [p.1339](../pdf/rp2350.pdf#page=1339) |
| clocks | GPIN0/GPIN1 clock inputs |  |  |  | 50 | MHz | GPIN0 = GPIO20, GPIN1 = GPIO22 (FREQ_QUARTZ!) → measurable with FC0 | [p.19](../pdf/rp2350.pdf#page=19) |
| clocks | FC0 longest interval | FC0_INTERVAL |  |  | 32 ms → 62.5 Hz |  | accuracy vs interval | [p.476](../pdf/rp2350.pdf#page=476) |

_Pages are PDF page numbers (they match the `=== p.N ===` markers in the text file)._
