will-conrad/plasma-donut/docs/parts/st7565r.md

# ST7565R

| | |
|---|---|
| Manufacturer | Sitronix |
| Role on board | LCD controller inside the NHD-C12864LZ |
| Ref des | (inside DS1) |
| Datasheet | [pdf/st7565r.pdf](../pdf/st7565r.pdf) · text [text/st7565r.txt](../text/st7565r.txt) · 72 pages |
| Revision | Ver 1.7c (2009/09/14) |
| Source | https://newhavendisplay.com/content/app_notes/ST7565R.pdf |
| Requirements / checks | REQ-12; DC-04 (see [design-requirements.md](../design-requirements.md), [ISSUES.md](../ISSUES.md)) |

## How it's used on this board

- The controller inside the NHD LCD. The NHD sheet doesn't cover SPI timing, the command set or absolute max ratings, so go here.

## Gotchas and design notes

- 4-wire SPI is **write-only** (p.24), so the LCD's MISO isn't needed.
- Data is sampled on the SCL rising edge, MSB first, with A0 read on every 8th clock (p.24). SPI mode 0 works, and it's the same mode as the MCP3208.
- SPI clock period ≥ 50 ns at 3.3 V (20 MHz), or ≥ 100 ns at 2.7 V (10 MHz) (p.64). Use ≤ 10 MHz for margin.
- The datasheet warns that SCL is sensitive to reflections and noise (p.24). Near a 13.56 MHz field, that's the reason for the periodic re-init in the firmware brief.
- /RES needs a low pulse of at least 1 µs at 3.3 V and at least 2 µs at 2.7 V (p.65).

## Key specs (from the datasheet)

| Category | Parameter | Sym | Min | Typ | Max | Unit | Conditions | Page |
|---|---|---|---|---|---|---|---|---|
| absmax | Supply VDD / VDD2 | VDD | -0.3 |  | 3.6 | V |  | [p.56](../pdf/st7565r.pdf#page=56) |
| absmax | V0, VOUT |  | -0.3 |  | 13.5 | V |  | [p.56](../pdf/st7565r.pdf#page=56) |
| timing | 4-line SPI clock period | tSCYC | 50 |  |  | ns | VDD = 3.3 V (100 ns at 2.7 V) | [p.64](../pdf/st7565r.pdf#page=64) |
| timing | SCL high / low width | tSHW/tSLW | 25 |  |  | ns | VDD = 3.3 V (50 ns at 2.7 V) | [p.64](../pdf/st7565r.pdf#page=64) |
| timing | A0 setup / hold | tSAS/tSAH | 20 / 10 |  |  | ns | VDD = 3.3 V (30/20 ns at 2.7 V) | [p.64](../pdf/st7565r.pdf#page=64) |
| timing | SI setup / hold | tSDS/tSDH | 20 / 10 |  |  | ns | VDD = 3.3 V | [p.64](../pdf/st7565r.pdf#page=64) |
| timing | CS–SCL time | tCSS/tCSH | 20 / 40 |  |  | ns | VDD = 3.3 V (30/60 ns at 2.7 V) | [p.64](../pdf/st7565r.pdf#page=64) |
| timing | Reset low pulse width | tRW | 1.0 |  |  | µs | VDD = 3.3 V (2.0 µs at 2.7 V) | [p.65](../pdf/st7565r.pdf#page=65) |
| timing | Reset time | tR |  |  | 1.0 | µs | VDD = 3.3 V (2.0 µs at 2.7 V) | [p.65](../pdf/st7565r.pdf#page=65) |
| interface | SPI data format |  |  |  |  |  | SI sampled on SCL rising edge, MSB (D7) first; A0 read every 8th clock; write-only (no reads in SPI mode) | [p.24](../pdf/st7565r.pdf#page=24) |
| interface | SCL noise caution |  |  |  |  |  | SCL sensitive to line-end reflections and external noise — recheck on real hardware | [p.24](../pdf/st7565r.pdf#page=24) |

_Pages are PDF page numbers (they match the `=== p.N ===` markers in the text file)._
