will-conrad/plasma-donut/Footprints/74LVC1G17GV-Q100_1/74LVC1G17GV-Q100_1.step

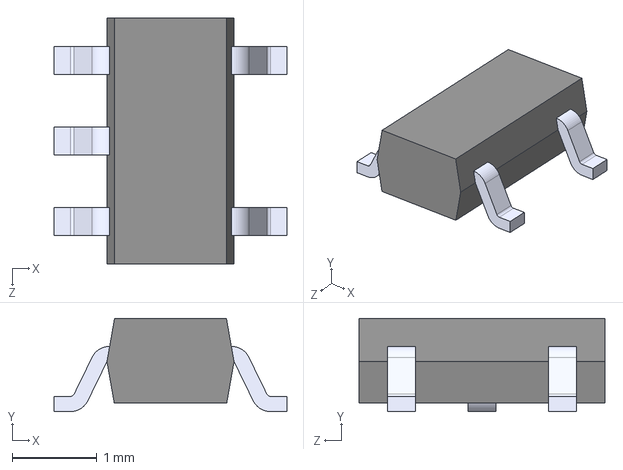
[picture p2: CAD file, 2026-11-03, last stored version]
Footprints/74LVC1G17GV-Q100_1/74LVC1G17GV-Q100_1.step
2.75 x 1.10 x 2.90 mm
