will-conrad/plasma-donut/Footprints/NHD-C12864LZ-FSW-FBW-3V3/NHD-C12864LZ-FSW-FBW-3V3.step

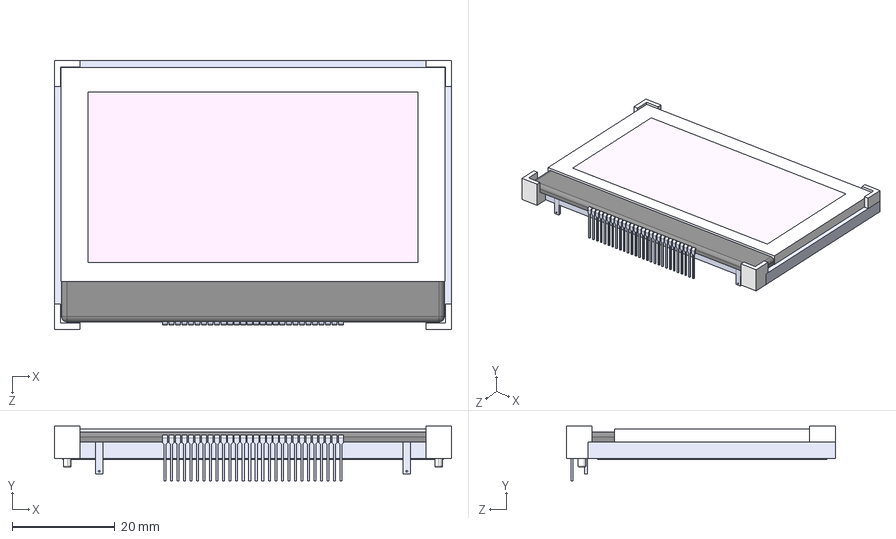
[picture p3: CAD file, 2026-11-03, last stored version]
Footprints/NHD-C12864LZ-FSW-FBW-3V3/NHD-C12864LZ-FSW-FBW-3V3.step
77.4 x 10.7 x 52.4 mm
