will-conrad/plasma-donut/docs/ISSUES.md

# Control board: issues and fixes using parts on hand

Constraint: no new purchases. Every fix below uses parts already bought (see [BOM-vs-orders.md](BOM-vs-orders.md)), a bodge wire, a firmware change, or an operating procedure. The math behind each issue is in [design-requirements.md](design-requirements.md) (DC-xx).

**Status (2026-11-01):** firmware fixes for #5, #6, #7, #8, #11, #15 and #16 are implemented in `CAPSTONE/pico-firmware` (see FIXES.md there; host tests pass, hardware bring-up still to do). Hardware steps for #1–#6 and #12 are in [REWORK.md](REWORK.md), with a board map.

Severity: **🔴 high** (can damage parts or block a milestone) · **🟠 medium** (wrong or missing readings) · **🟡 low** (margin or cleanliness)

| # | Sev | Issue | Fix (owned parts only) | Effort |
|---|---|---|---|---|
| 1 | 🔴 | **Order 8 hasn't arrived** (Digi-Key shipment delayed per the 10/30 course note). It contains all 12 screw terminals (1715022), R19/R22 7.15k, C36 10 pF, C37 330 pF and D1 BAT54WS-TP. Separately, the 1 nF C0G (C30/C34), R3 10 Ω, the switches and the 14-pin header were only on the unpriced "Additions" sheet, so it's unconfirmed they were ordered. | **Bring-up doesn't have to wait.** Solder wires straight into the 5 mm terminal holes. For R19/R22, use 10k for now: bias 1.65 V, the originally simulated case, which needs ≥ 0.76 V pk at the Schmitt, i.e. ≥ 26 V pk at J16/J17. R3 can be a solder bridge (DC-04). C30/C34 can be Alexis's 1 nF radial C0G (C323C102KAG5TA, order 8) or Brennan's 10 nF 0603 (GRM1885C1H103JA01D) on the 0805 pads. The passive-coil detector (C36/C37/D1) can stay unpopulated until order 8 lands. **Check the parts bin against the "Additions" list first.** | low |
| 2 | 🔴 | **GND–GNDA tie is undefined** (DC-06). The PCB has no net-tie. If the Pico doesn't tie AGND to GND internally, GNDA current returns through the MCP3208 die (AGND/DGND substrate is only 5–10 Ω, mcp3208 p.24). | **Before power-up:** measure resistance TP7 (GND) ↔ TP8 (GNDA) with the Pico fitted. **< 0.5 Ω:** fine, the Pico ties them. **Higher:** add one short bodge wire TP7 → TP8 (a single deliberate tie point). Optional, per the datasheet: lift U1 pin 9 (DGND) and wire it to GNDA (C16's ground pad is 2.4 mm away). | low |
| 3 | 🔴 | **Hot-plug overshoot on J1.** A ceramic-only input (C1 1 µF) can ring to about 2× the supply voltage when a live supply is connected (AN88). That's about 10 V, against the LM66100's **6 V absolute max** (lm66100 p.4). | **Procedure:** wire J1 with the supply output **off**, then turn it on. Set the current limit to about 300 mA and the voltage to **5.0 V, never above 5.5 V**. Label J1 "5.0 V ONLY". Optional: piggyback a spare 10 µF (CL31B106KLHNNNE, 8 left) on C1; more capacitance lowers the ring frequency, but ceramics add little damping. | none |
| 4 | 🟠 | **Pickup amplitude window is narrow and unmeasured** (DC-08). The Schmitt only toggles cleanly for about 17–47 V pk at J16/J17, and R25/R27 (1/8 W) overheat above about 50 V pk. | **First, scope the real pickup voltage at J16/J17.** Then rescale **R25/R27 only** from stock values (1k, 1k+1k, 10k∥10k, 10k, 10k+10k, 100k∥100k). The table with each option's working window is in [REWORK.md](REWORK.md) step D. | low |
| 5 | 🟠 | **Coil A/B frequencies never reach the Pico** (DC-10). SQ_A/SQ_B go only to U3 and TP3/TP4. MCP3208 CH4/CH5 (/PICKUP_A/B) are floating. | **Firmware:** never display CH4/CH5 (they read noise). Coil frequency = f_osc by design, since one crystal drives both coils. **Optional bodge:** TP3 → **J15 pin 7 (GP5, PWM2 B)** and TP4 → **J15 pin 9 (GP7, PWM3 B)**, each through a spare **330 Ω** in series. That gives per-coil "switching?" flags and f_A/f_B. **Optional amplitude bodge** for the brief's phase "?" flag: from each R26/R28 top (TAP_SENSE) → spare **BAT54WS** (order 8) → existing C24/C25 node, plus a **100k** bleed to GNDA, so CH4/CH5 read coil amplitude. | low |
| 6 | 🟠 | **GPIO22 can't count edges with PWM, and may see 5 V** (DC-11). The ordered oscillator (LFSPXO025876) is 5 V HCMOS. GPIO22 tolerates 5.5 V only while the Pico is powered (3.63 V unpowered, rp2350 p.1336). | **Firmware:** measure it as **GPIN1 with the FC0 frequency counter** (rp2350 p.19, p.476; 62.5 Hz accuracy in 32 ms), or with a PIO counter. **Hardware, if J9 carries the raw 5 V output:** add **two 1 kΩ in parallel** (500 Ω) from GP22 to GND, next to the Pico. With R14 (330 Ω) that forms a 0.60 divider, so 5 V becomes 3.0 V (VIH 2.0 V ✅), safe even when the Pico is unpowered. It loads the oscillator by about 6 mA, so check its drive with Brennan. Otherwise, **power the control board before the oscillator.** | low |
| 7 | 🟠 | **Backlight current and R1 power at the corners** (DC-14). At ≥ 5.25 V or with a low-VLED part, current goes past 100 mA and R1 (1206, 0.25 W) past its rating. | At J1 = 5.0 V the worst corner is 96 mA / 0.22 W, which is in spec even at 100 % duty. **Firmware:** cap the backlight PWM at **75 % duty** for margin against a high supply. At 5.25 V that's ≤ 80 mA average and ≤ 0.20 W in R1. The peak current still follows the supply voltage, so the supply limit below is the real fix. **Procedure:** keep J1 at 5.0 V (issue 3). No hardware change: 24 Ω is the right nominal value, and the duty cap covers the corners. | none |
| 8 | 🟠 | **VDD readings low by up to 8 % if the ADC samples continuously** (DC-07: RIN_ADC ≥ 100 kΩ against a 9.1 kΩ divider). Same for the passive level. | **Firmware:** read GPIO26/27/28 in short bursts (16 samples), at least 5 ms apart. Add a one-point gain calibration per channel against a multimeter, saved in `cal.json`. | none |
| 9 | 🟠 | **Cable grounds mix GND and GNDA** (DC-06). J11/J12 return on GNDA, while J9/J10/J16/J17 return on GND. If the HV board joins them, you get an RF ground loop through the control board. | **Wiring rule, no parts:** run one dedicated ground wire from the HV board to the control board at TP7 (GND). At J11/J12, connect pin 1 (GNDA) only at the control-board end, and don't also tie it to HV ground through another path. Twist each signal with its own return. Agree this with Brennan. | none |
| 10 | 🟡 | **Phantom powering:** if the HV supply is on while the Pico is off, the VDD taps and J9 back-feed the dead 3V3 rail through the input diodes (pico2 p.15). | **Procedure:** control board on first, off last. Put it in the bring-up checklist. | none |
| 11 | 🟡 | **Phase offset of up to about 23°** from U4/U5 skew plus bias-centre offset (DC-09). | **Firmware:** zero-phase calibration (same signal into J16 and J17) **at the real operating amplitude**. Repeat it if you change R25–R28 (issue 4). | none |
| 12 | 🟡 | **MCP3208 VDD has 0.1 µF**; the datasheet asks for 1 µF (mcp3208 p.23). | Stack a spare **1 µF (C0805C105K3RACTU)** on top of C15. | 5 min |
| 13 | 🟡 | **LM66100 ST pin floating**; the datasheet says tie it to GND if unused (lm66100 p.3). It's open-drain, so this is benign. | Leave it. Optionally bridge pin 5 to a nearby GND pad. | — |
| 14 | 🟡 | **LCD VDD at its 3.3 V maximum** (nhd p.7). | Measure TP2. If it's above 3.35 V, report it; there's no owned-part fix needed (ST7565R absolute max is 3.6 V). | — |
| 15 | 🟡 | **Thermistor leads near the RF coils** (DC-05). | Twist the J3–J6 pairs, route them away from the coil, and keep C18–C21. Firmware should flag open (≈4095) and shorted (≈0) sensors. | none |
| 16 | 🟡 | **Unused GPIOs float** (GP9 and the J15 spares). E9 leakage holds floating inputs near 2.2 V (rp2350 p.1359). | **Firmware:** enable pull-ups on unused pins, or disable their input buffers. | none |
| 17 | 🟡 | **Only one LCD bought** (NHD-C12864LZ ×1), so there's no spare. | Handle it with ESD care and fit it last. Test SPI with a logic analyzer before attaching. | — |
| 18 | 🟡 | Schematic housekeeping: the A1 symbol and datasheet link are for the Pico 1; GND/GNDA power symbols carry a stray `PLCC-84` footprint field; the firmware brief still says 82k/9.2 and τ = 2.1 ms. | Update the documentation in the next revision. `config.py` already uses ÷11 and 1 ms. | — |

## Bring-up order that respects these issues
1. Bare board: meter TP7↔TP8 (issue 2) and check for shorts on +5V/VCC/VREF.
2. Power from USB only: check TP2 ≈ 3.3 V (issue 14) and TP1 ≈ 4.6 V.
3. J1 at 5.0 V, with the supply turned on *after* wiring (issue 3).
4. Firmware steps from the brief, with: CH4/5 hidden, burst ADC sampling plus calibration, the 75 % backlight cap, and FC0/GPIN1 for f_osc.
5. Scope J16/J17/J10 on the live rig **before** trusting phase or passive-level readings (issues 4 and 6), then rescale and calibrate.

Sources: [Linear Technology AN88, Ceramic Input Capacitors Can Cause Overvoltage Transients](https://www-cce.cldnet.analog.com/media/en/technical-documentation/application-notes/an88f.pdf) · [IQD LFSPXO025876 listing (5 V HCMOS, 13.56 MHz)](https://www.digikey.hk/en/products/detail/iqd-frequency-products/LFSPXO025876/10106603) · all other references are the datasheets in `pdf/` (page keys in `specs.csv`).
