will-conrad/plasma-donut/Microcontroller-PCB/Microcontroller-PCB.kicad_pcb

## KiCad design Microcontroller-PCB/Microcontroller-PCB.kicad_pcb (2026-11-03, last stored version)

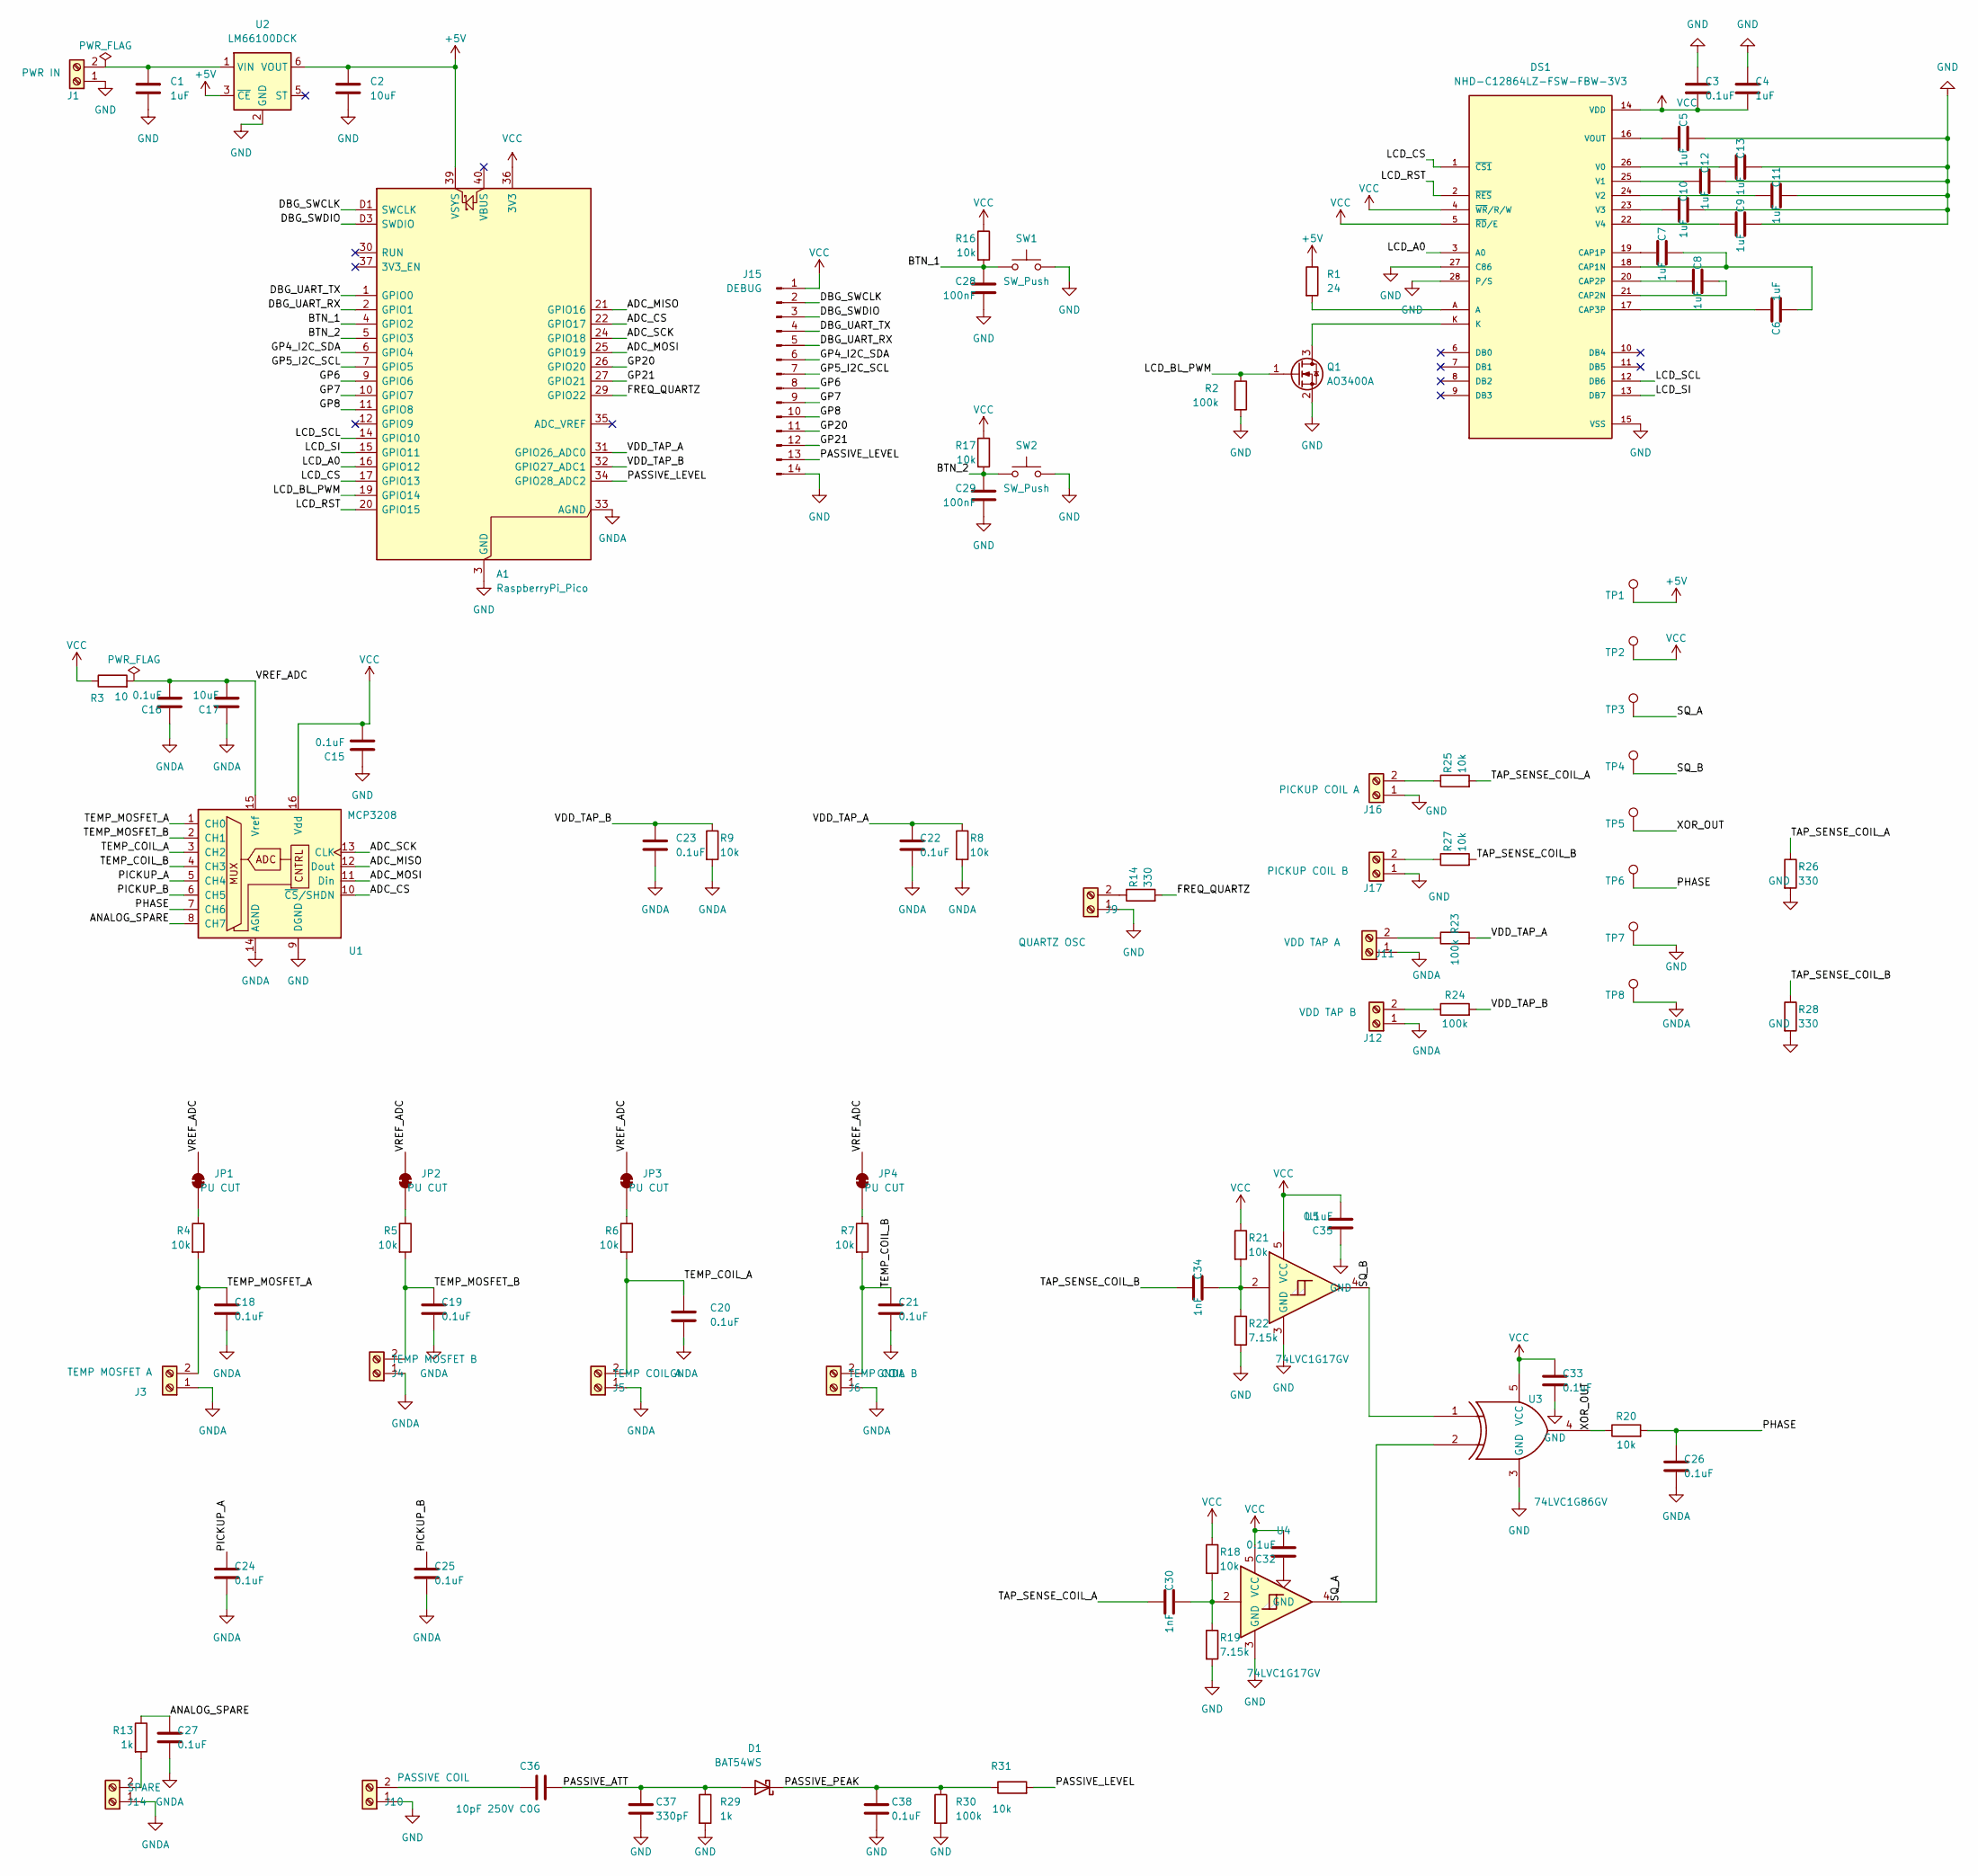
[picture p4: schematic Microcontroller-PCB.kicad_sch]

Parts:
A1: RaspberryPi_Pico; RaspberryPi_Pico_SMD_HandSolder
C1, C4, C5, C6, C7, C8, C9, C10, C11, C12, C13: 1uF; C_0805_2012Metric_Pad1.18x1.45mm_HandSolder
C2, C17: 10uF; C_1206_3216Metric_Pad1.33x1.80mm_HandSolder
C3, C15, C16, C18, C19, C20, C21, C22, C23, C24, C25, C26, C27, C32, C33, C35, C38: 0.1uF; C_0805_2012Metric_Pad1.18x1.45mm_HandSolder
C28, C29: 100nF; C_0805_2012Metric_Pad1.18x1.45mm_HandSolder
C30, C34: 1nF; C_0805_2012Metric_Pad1.18x1.45mm_HandSolder
C36: 10pF 250V C0G; C_0805_2012Metric_Pad1.18x1.45mm_HandSolder
C37: 330pF; C_0805_2012Metric_Pad1.18x1.45mm_HandSolder
D1: BAT54WS; D_SOD-323_HandSoldering
DS1: NHD-C12864LZ-FSW-FBW-3V3; LCD_NHD-C12864LZ-FSW-FBW-3V3; PARTREV 1.0
J1: PWR IN; TerminalBlock_Phoenix_MKDS-1,5-2_1x02_P5.00mm_Horizontal
J3: TEMP MOSFET A; TerminalBlock_Phoenix_MKDS-1,5-2_1x02_P5.00mm_Horizontal
J4: TEMP MOSFET B; TerminalBlock_Phoenix_MKDS-1,5-2_1x02_P5.00mm_Horizontal
J5: TEMP COIL A; TerminalBlock_Phoenix_MKDS-1,5-2_1x02_P5.00mm_Horizontal
J6: TEMP COIL B; TerminalBlock_Phoenix_MKDS-1,5-2_1x02_P5.00mm_Horizontal
J9: QUARTZ OSC; TerminalBlock_Phoenix_MKDS-1,5-2_1x02_P5.00mm_Horizontal
J10: PASSIVE COIL; TerminalBlock_Phoenix_MKDS-1,5-2_1x02_P5.00mm_Horizontal
J11: VDD TAP A; TerminalBlock_Phoenix_MKDS-1,5-2_1x02_P5.00mm_Horizontal
J12: VDD TAP B; TerminalBlock_Phoenix_MKDS-1,5-2_1x02_P5.00mm_Horizontal
J14: SPARE; TerminalBlock_Phoenix_MKDS-1,5-2_1x02_P5.00mm_Horizontal
J15: DEBUG; PinHeader_1x14_P2.54mm_Vertical
J16: PICKUP COIL A; TerminalBlock_Phoenix_MKDS-1,5-2_1x02_P5.00mm_Horizontal
J17: PICKUP COIL B; TerminalBlock_Phoenix_MKDS-1,5-2_1x02_P5.00mm_Horizontal
JP1, JP2, JP3, JP4: PU CUT; SolderJumper-2_P1.3mm_Bridged_RoundedPad1.0x1.5mm
Q1: AO3400A; SOT-23
R1: 24; R_1206_3216Metric_Pad1.30x1.75mm_HandSolder
R2, R23, R24, R30: 100k; R_0805_2012Metric_Pad1.20x1.40mm_HandSolder
R3: 10; R_0805_2012Metric_Pad1.20x1.40mm_HandSolder
R4, R5, R6, R7, R8, R9, R16, R17, R18, R20, R21, R25, R27, R31: 10k; R_0805_2012Metric_Pad1.20x1.40mm_HandSolder
R13, R29: 1k; R_0805_2012Metric_Pad1.20x1.40mm_HandSolder
R14, R26, R28: 330; R_0805_2012Metric_Pad1.20x1.40mm_HandSolder
R19, R22: 7.15k; R_0805_2012Metric_Pad1.20x1.40mm_HandSolder
SW1, SW2: SW_Push; SW_PUSH_6mm
TP1: +5V; TestPoint_THTPad_D2.0mm_Drill1.0mm
TP2: 3V3; TestPoint_THTPad_D2.0mm_Drill1.0mm
TP3: SQ A; TestPoint_THTPad_D2.0mm_Drill1.0mm
TP4: SQ B; TestPoint_THTPad_D2.0mm_Drill1.0mm
TP5: XOR; TestPoint_THTPad_D2.0mm_Drill1.0mm
TP6: PHASE; TestPoint_THTPad_D2.0mm_Drill1.0mm
TP7: GND; TestPoint_THTPad_D2.0mm_Drill1.0mm
TP8: GNDA; TestPoint_THTPad_D2.0mm_Drill1.0mm
U1: MCP3208; SOIC-16_3.9x9.9mm_P1.27mm
U2: LM66100DCK; SOT-363_SC-70-6
U3: 74LVC1G86GV; 74LVC1G86GV_125
U4, U5: 74LVC1G17GV; SOT95P275X110-5N

Connections:
+5V: A1.39 (VSYS), C2.1, R1.1, TP1.1, U2.3 (~CE), U2.6 (VOUT)
/ADC_CS: A1.22 (GPIO17), U1.10 (~CS/SHDN)
/ADC_MISO: A1.21 (GPIO16), U1.12 (Dout)
/ADC_MOSI: A1.25 (GPIO19), U1.11 (Din)
/ADC_SCK: A1.24 (GPIO18), U1.13 (CLK)
/ANALOG_SPARE: C27.1, R13.1, U1.8 (CH7)
/BTN_1: A1.4 (GPIO2), C28.1, R16.2, SW1.1
/BTN_2: A1.5 (GPIO3), C29.1, R17.2, SW2.1
/DBG_SWCLK: A1.D1 (SWCLK), J15.2
/DBG_SWDIO: A1.D3 (SWDIO), J15.3
/DBG_UART_RX: A1.2 (GPIO1), J15.5
/DBG_UART_TX: A1.1 (GPIO0), J15.4
/FREQ_QUARTZ: A1.29 (GPIO22), R14.2
/GP4_I2C_SDA: A1.6 (GPIO4), J15.6
/GP5_I2C_SCL: A1.7 (GPIO5), J15.7
/GP6: A1.9 (GPIO6), J15.8
/GP7: A1.10 (GPIO7), J15.9
/GP8: A1.11 (GPIO8), J15.10
/GP20: A1.26 (GPIO20), J15.11
/GP21: A1.27 (GPIO21), J15.12
/LCD_A0: A1.16 (GPIO12), DS1.3 (A0)
/LCD_BL_PWM: A1.19 (GPIO14), Q1.1 (G), R2.1
/LCD_CS: A1.17 (GPIO13), DS1.1 (~CS1)
/LCD_RST: A1.20 (GPIO15), DS1.2 (~RES)
/LCD_SCL: A1.14 (GPIO10), DS1.12 (DB6)
/LCD_SI: A1.15 (GPIO11), DS1.13 (DB7)
/PASSIVE_ATT: C36.2, C37.1, D1.2 (A), R29.1
/PASSIVE_LEVEL: A1.34 (GPIO28_ADC2), J15.13, R31.2
/PASSIVE_PEAK: C38.1, D1.1 (K), R30.1, R31.1
/PHASE: C26.1, R20.2, TP6.1, U1.7 (CH6)
/PICKUP_A: C24.1, U1.5 (CH4)
/PICKUP_B: C25.1, U1.6 (CH5)
/SQ_A: TP3.1, U3.2, U4.4
/SQ_B: TP4.1, U3.1, U5.4
/TAP_SENSE_COIL_A: C30.1, R25.2, R26.1
/TAP_SENSE_COIL_B: C34.1, R27.2, R28.1
/TEMP_COIL_A: C20.1, J5.2, R6.2, U1.3 (CH2)
/TEMP_COIL_B: C21.1, J6.2, R7.2, U1.4 (CH3)
/TEMP_MOSFET_A: C18.1, J3.2, R4.2, U1.1 (CH0)
/TEMP_MOSFET_B: C19.1, J4.2, R5.2, U1.2 (CH1)
/VDD_TAP_A: A1.31 (GPIO26_ADC0), C22.1, R8.1, R23.2
/VDD_TAP_B: A1.32 (GPIO27_ADC1), C23.1, R9.1, R24.2
/VREF_ADC: C16.2, C17.2, JP1.2 (B), JP2.2 (B), JP3.2 (B), JP4.2 (B), R3.2, U1.15 (Vref)
/XOR_OUT: R20.1, TP5.1, U3.4
GND: A1.3 (GND), A1.8 (GND), A1.13 (GND), A1.18 (GND), A1.23 (GND), A1.28 (GND), A1.38 (GND), A1.D2 (GND), C1.2, C2.2, C3.1, C4.1, C5.2, C9.2, C10.2, C11.2, C12.2, C13.2, C15.1, C28.2, C29.2, C32.1, C33.2, C35.1, C37.2, C38.2, DS1.15 (VSS), DS1.27 (C86), DS1.28 (P/S), J1.1, J9.1, J10.1, J15.14, J16.1, J17.1, Q1.2 (S), R2.2, R19.2, R22.2, R26.2, R28.2, R29.2, R30.2, SW1.2, SW2.2, TP7.1, U1.9 (DGND), U2.2 (GND), U3.3 (GND), U4.3 (GND), U5.3 (GND)
GNDA: A1.33 (AGND), C16.1, C17.1, C18.2, C19.2, C20.2, C21.2, C22.2, C23.2, C24.2, C25.2, C26.2, C27.2, J3.1, J4.1, J5.1, J6.1, J11.1, J12.1, J14.1, R8.2, R9.2, TP8.1, U1.14 (AGND)
unnamed: C30.2, R18.2, R19.1, U4.2
unnamed: C34.2, R21.2, R22.1, U5.2
unnamed: C6.1, C7.2, DS1.18 (CAP1N)
unnamed: C7.1, DS1.19 (CAP1P)
unnamed: C8.2, DS1.21 (CAP2N)
unnamed: C8.1, DS1.20 (CAP2P)
unnamed: C6.2, DS1.17 (CAP3P)
unnamed: DS1.A, R1.2
unnamed: C13.1, DS1.26 (V0)
unnamed: C12.1, DS1.25 (V1)
unnamed: C11.1, DS1.24 (V2)
unnamed: C10.1, DS1.23 (V3)
unnamed: C9.1, DS1.22 (V4)
unnamed: C5.1, DS1.16 (VOUT)
unnamed: C1.1, J1.2, U2.1 (VIN)
unnamed: J9.2, R14.1
unnamed: C36.1, J10.2
unnamed: J11.2, R23.1
unnamed: J12.2, R24.1
unnamed: J14.2, R13.2
unnamed: J16.2, R25.1
unnamed: J17.2, R27.1
unnamed: JP1.1 (A), R4.1
unnamed: JP2.1 (A), R5.1
unnamed: JP3.1 (A), R6.1
unnamed: JP4.1 (A), R7.1
unnamed: DS1.K, Q1.3 (D)
VCC: A1.36 (3V3), C3.2, C4.2, C15.2, C32.2, C33.1, C35.2, DS1.4 (~WR/R/W), DS1.5 (~RD/E), DS1.14 (VDD), J15.1, R3.1, R16.1, R17.1, R18.1, R21.1, TP2.1, U1.16 (Vdd), U3.5 (VCC), U4.5 (VCC), U5.5 (VCC)

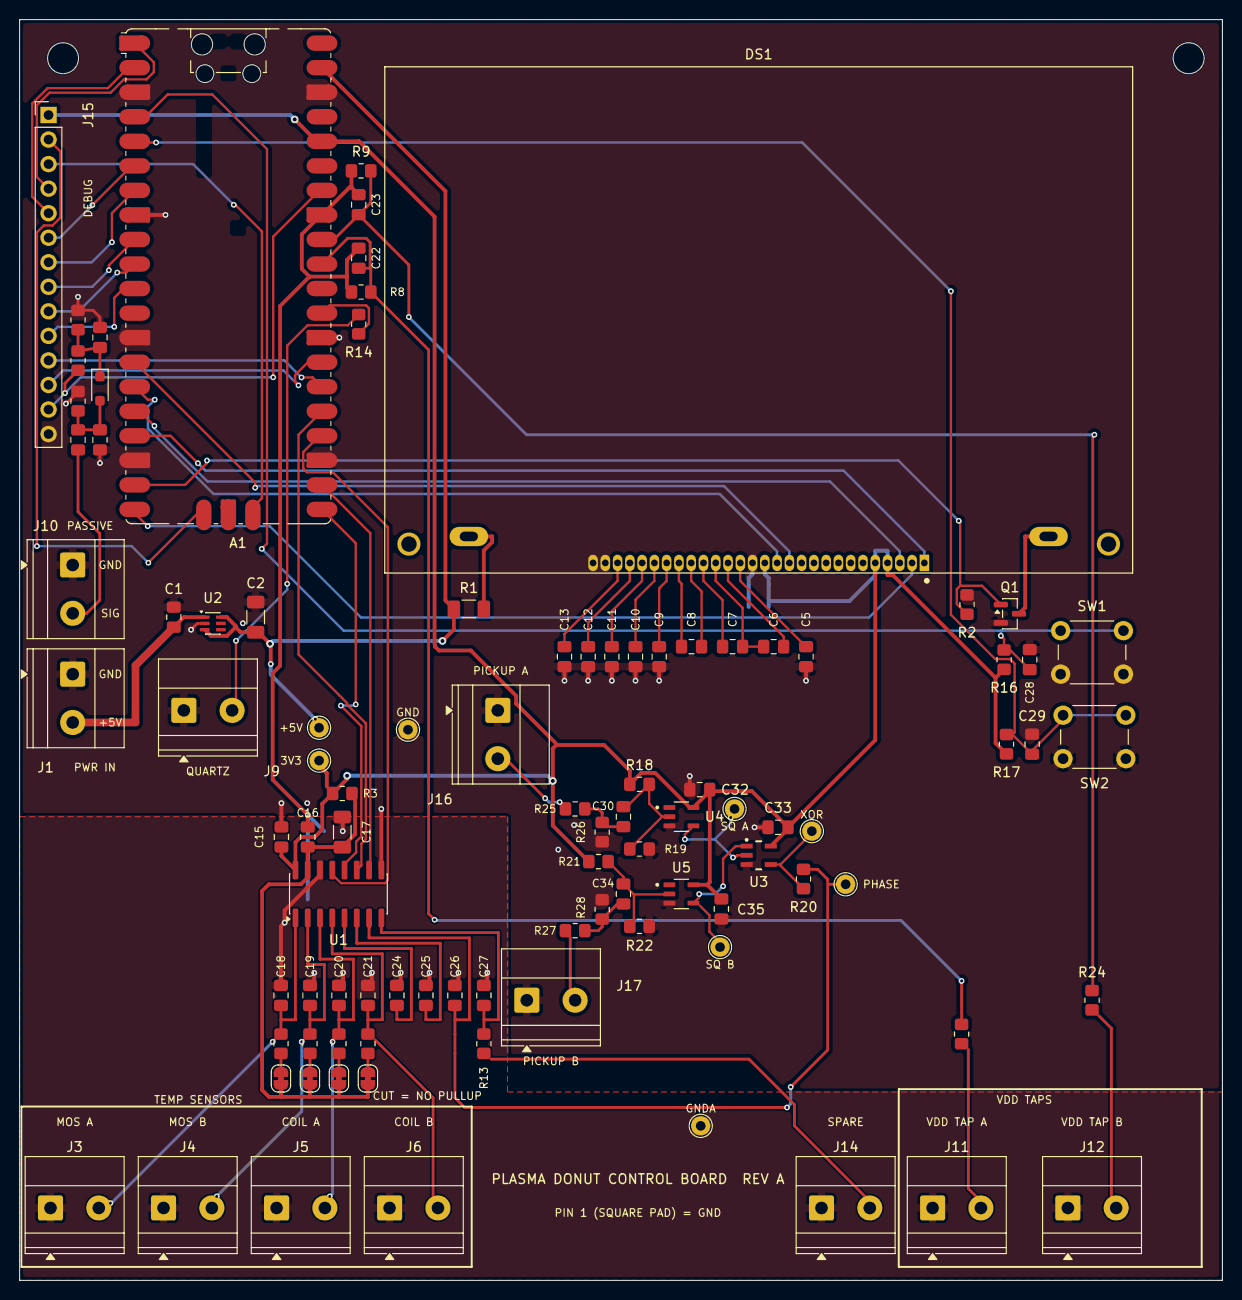
[picture p5: board Microcontroller-PCB.kicad_pcb from above]

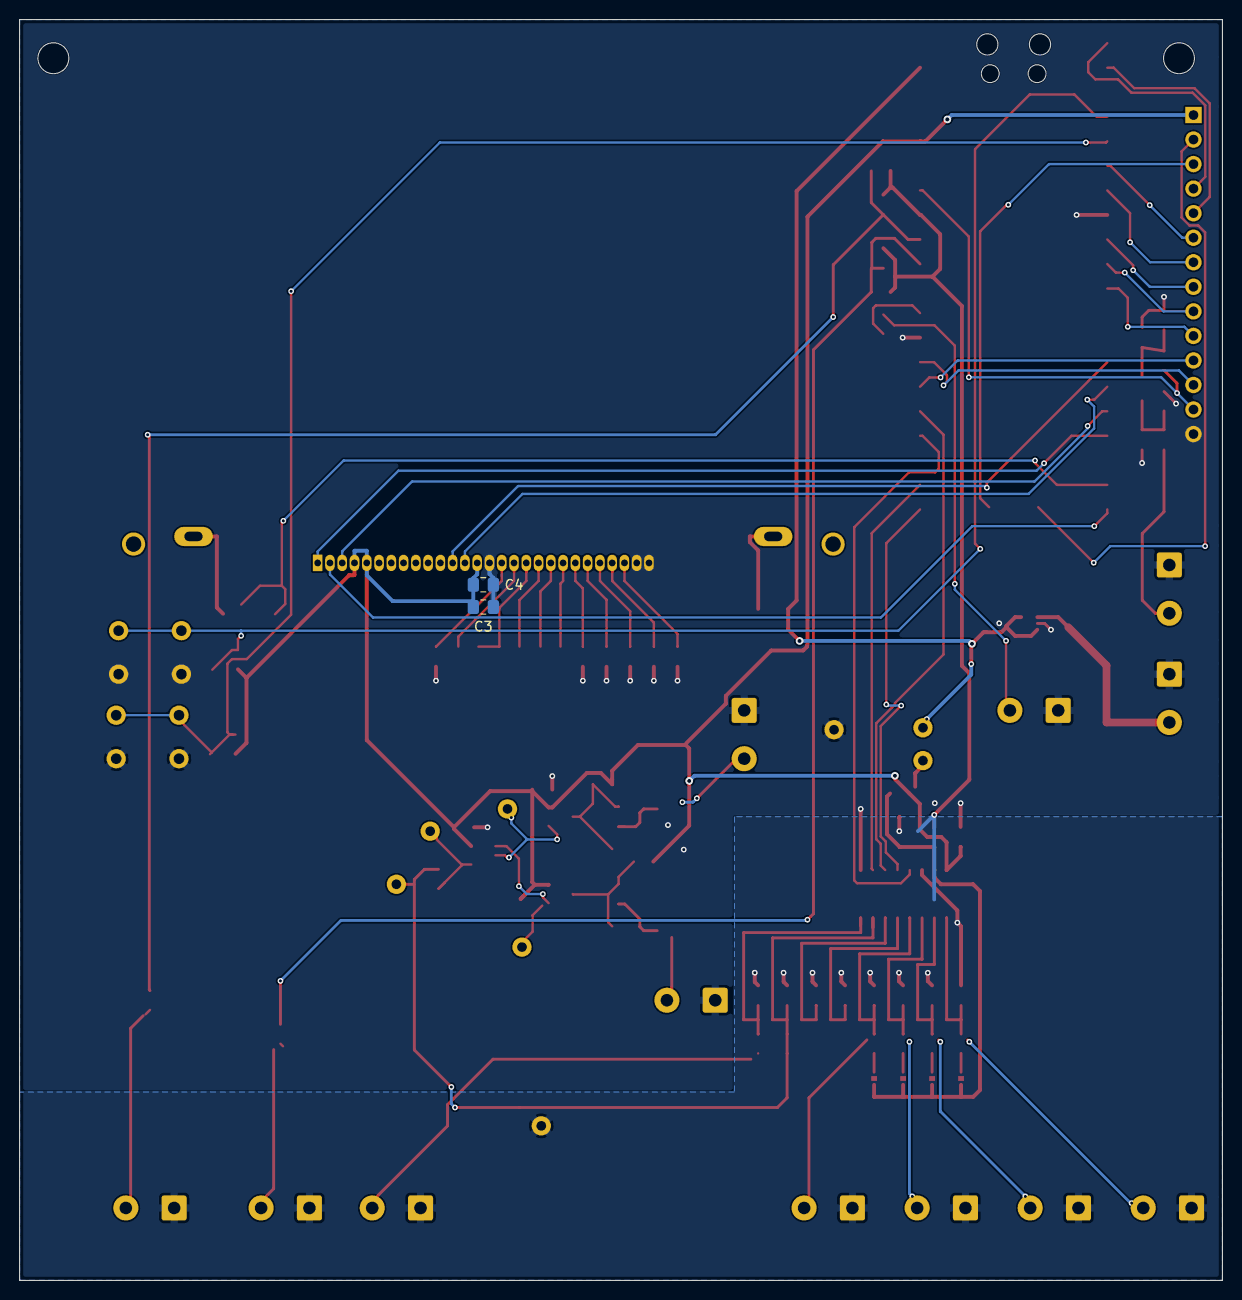
[picture p6: board Microcontroller-PCB.kicad_pcb from below]

Board: 2 copper layers, 124.5 x 130.5 mm, 101 parts (2 on the bottom side), 74 nets.

Other parts of the board:
H1, H2: M3; MountingHole_3.2mm_M3
