will-conrad/plasma-donut/Pulse Generator/KiCad Project/spark/spark.kicad_pcb

## KiCad design Pulse Generator/KiCad Project/spark/spark.kicad_pcb (2026-11-03, last stored version)

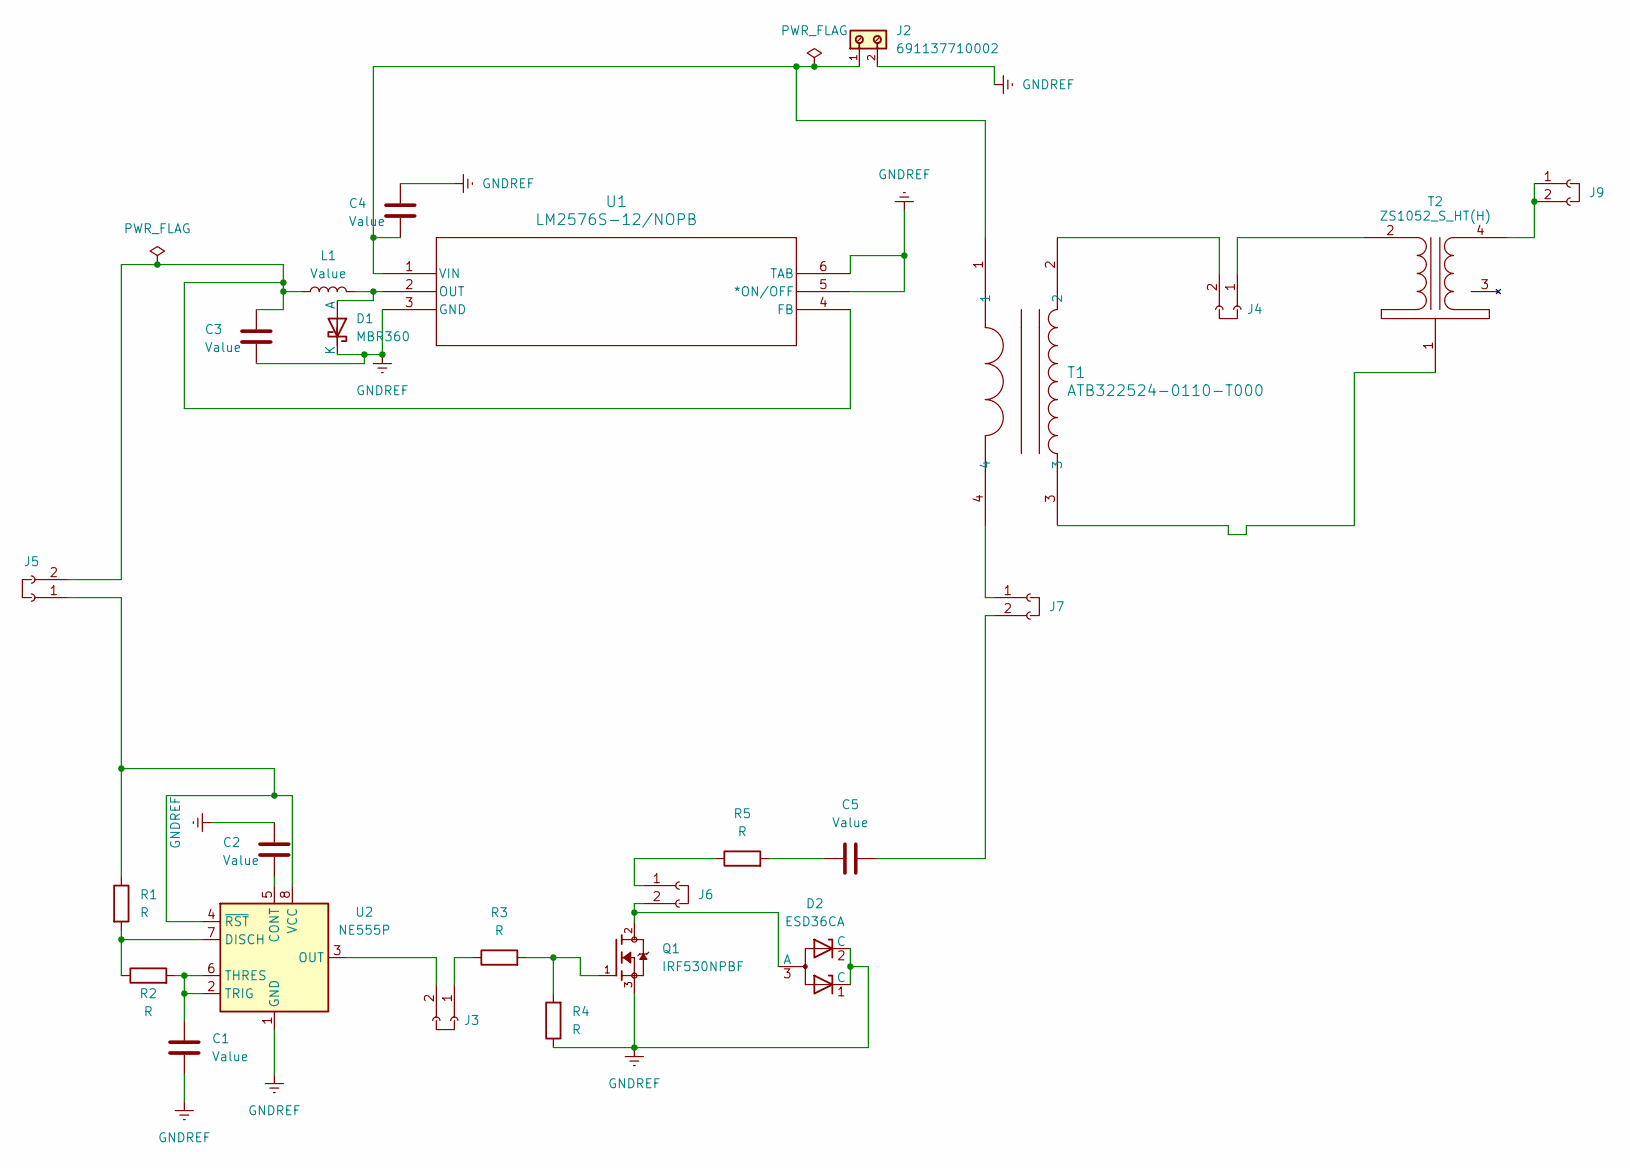
[picture p7: schematic spark.kicad_sch]

Parts:
C1, C2, C3, C4, C5: Value; capacitor_200mil_pitch
D1: MBR360; P2_DO-201
D2: ESD36CA; P200_SOT-23
J2: 691137710002
J3, J4, J5, J6, J7, J9: 0; 2_pin_header
L1: Value; inductor
Q1: IRF530NPBF; TO254P1041X444X1930-3; PARTREV 01/30/04; DigiKey_Part_Number IRF530NPBF-ND
R1, R2, R3, R4, R5: R; resistor_horizontal
T1: ATB322524-0110-T000; CHOKE_524-0110-T000_TDK
T2: ZS1052_S_HT(H); ZS1052 S HT(H)
U1: LM2576S-12/NOPB; TS5B_TEX
U2: NE555P; DIP-8_W7.62mm

Connections:
GNDREF: C1.2, C2.2, C3.1, C4.2, D1.2 (K), D2.1 (C), D2.2 (C), J2.2, Q1.3, R4.1, U1.3 (GND), U1.5 (*ON/OFF), U1.6 (TAB), U2.1 (GND)
unnamed: C5.1, R5.2
unnamed: D1.1 (A), L1.2, U1.2 (OUT)
unnamed: D2.3 (A), J6.2, Q1.2
unnamed: J3.1, R3.1
unnamed: J3.2, U2.3 (OUT)
unnamed: J4.1, T2.2 (AA)
unnamed: J4.2, T1.2
unnamed: J5.1, R1.1, U2.4 (~RST), U2.8 (VCC)
unnamed: C3.2, J5.2, L1.1, U1.4 (FB)
unnamed: J6.1, R5.1
unnamed: J7.1, T1.4
unnamed: C5.2, J7.2
unnamed: J9.1, J9.2, T2.4 (SB)
unnamed: Q1.1, R3.2, R4.2
unnamed: T1.3, T2.1 (AB)
unnamed: C4.1, J2.1, T1.1, U1.1 (VIN)
unnamed: C2.1, U2.5 (CONT)
unnamed: R1.2, R2.1, U2.7 (DISCH)
unnamed: C1.1, R2.2, U2.2 (TRIG), U2.6 (THRES)

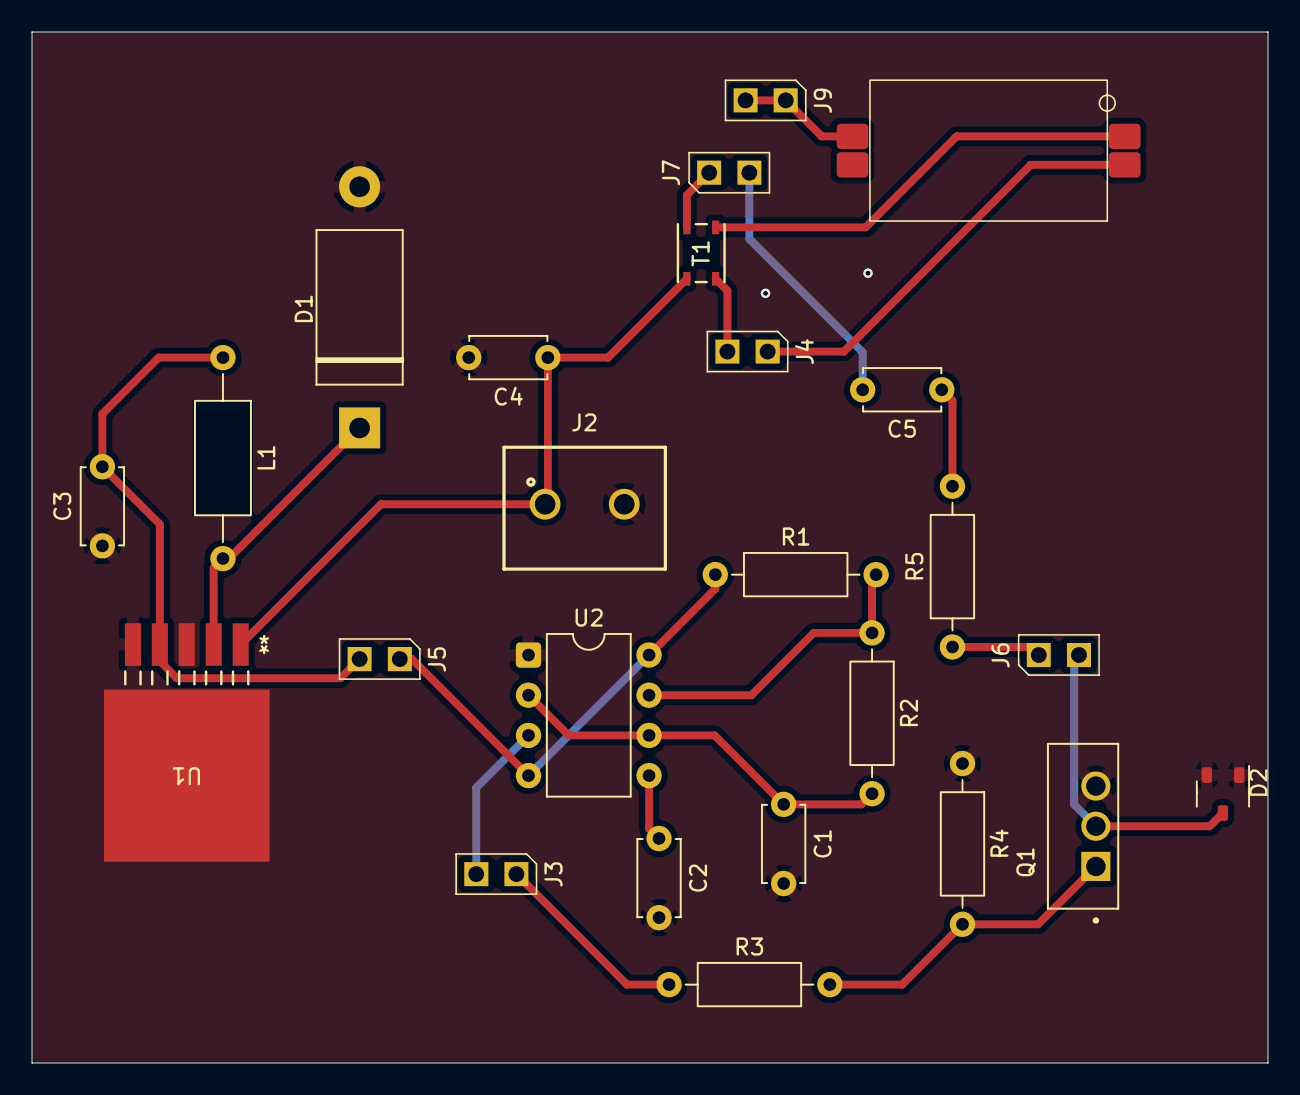
[picture p8: board spark.kicad_pcb from above]

Board: 2 copper layers, 78.1 x 65.2 mm, 25 parts (0 on the bottom side), 20 nets.
