will-conrad/plasma-donut/(commit log)

2026-09-09 Add first-pass system design: dual-frequency RF ignition/sustain, RPi control, BOM
    - README: architecture overview, key numbers, open risks, safety
    - docs/rf-design.md: why ignition (2.45 GHz, ISM) and sustain/detuning
    control (13.56 MHz, ISM) run at different frequencies, Class E stage
    design (parallel-circuit topology), why GHz needs a loop applicator
    instead of a wound coil
    - docs/control-system.md: Raspberry Pi -> ADF4351/AD9910 synthesis,
    reflection-coefficient-based ignition detection, detuning control loop
    - docs/bom.md: sourced parts list
    - docs/references.md: all sources used
    Grounded in published Class E GaN PA designs at 2.4 GHz, real 2.45 GHz
    plasma torch precedents, a p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
2026-11-03 Add current project state: control board, firmware, other boards, sims, enclosure
    - Microcontroller-PCB: KiCad 10 schematic/PCB, custom footprints, datasheet
    catalogue, issues/rework docs, flagcheck rule checker, DRC/ERC reports
    - pico-firmware: MicroPython control-board firmware + host tests
    - OSC-PCB, HaloPlasma, Pulse Generator (spark) KiCad projects
    - Sims, Enclosure CAD, shared Footprints
    - README: current layout; Sept docs marked superseded
    - .gitignore for KiCad backups/history/locks and vendor PDFs
    Claude-Session: https://claude.ai/code/session_01NBb3pdrt4PhpqVJYCXawCp
    [74LVC1G17GV-Q100_1.step, HaloPlasma.kicad_pcb, HaloPlasma.kicad_sch, Microcontroller-PCB.kicad_pcb, Microcontroller-PCB.kicad_sch, NHD-C12864LZ-FSW-FBW-3V3.step, OSC-PCB.kicad_pcb, OSC-PCB.kicad_sch]
2026-11-03 Pare repo down to Pico 2 firmware only
    Remove all PCB/KiCad projects, footprints, sims, enclosure CAD and the
    superseded Sept design docs. Move pico-firmware/ to the repo root and keep
    only what the firmware needs: src/, host tests, PINMAP, CLAUDE brief, FIXES,
    plus docs/ (ISSUES, REWORK, design requirements, claim-tag RULES, and
    datasheet notes/specs for the parts the firmware drives). Update internal
    doc paths to match.
    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
    [74LVC1G17GV-Q100_1.step, HaloPlasma.kicad_pcb, HaloPlasma.kicad_sch, Microcontroller-PCB.kicad_pcb, Microcontroller-PCB.kicad_sch, NHD-C12864LZ-FSW-FBW-3V3.step, OSC-PCB.kicad_pcb, OSC-PCB.kicad_sch]
2026-11-03 Add empty repo outline for the firmware rebuild
    src/{config,drivers,sensors,ui}, tests/host, tools — each with a README
    describing what belongs there. No code.
    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
2026-11-03 Switch firmware plan from MicroPython to C (Pico SDK 2.3.1)
    - CLAUDE.md: new Language and tools section (CMake, PICO_BOARD=pico2,
    UF2/picotool, stdio_usb, host-testable pure-C sensors, flash calibration
    with CRC), C layout, SDK equivalents for FC0/GPIN1, watchdog, timing
    - FIXES.md: marked as requirements carried over from the removed
    MicroPython implementation
    - README, src/*, tests/, tools/ outline READMEs and REWORK flag syntax
    updated for C; ignore build/
    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
